INSA-GEI/Voilier/README.md

# Voilier
Évolution du voilier utilisé dans l'apprentissage de la programmation de périphériques MCU

## Organisation du dépôt git
La structure du dépôt suit cette organisation:
- docs: Documentation du projet
- meca: Conception de pièces mécaniques et supports utilisé sur le projet (Autodesk Inventor)
- pcb: Conception des différentes cartes électronique composants le projet (Kicad / Altium)
- code: Code source des différents logiciels utilisés sur le projet (stm32CubeIDE / python)

## Contributeurs
L'équipe enseignante et l’équipe technique du département GEI, spécialité électronique, de l'INSA de Toulouse, France.

## Config XBEE

Voilier
Channel: F
PanID: 111
My : n
Dest : 0x80+n

Telecommande:
Channel: F
PanID: 111
My: 0x80+n
Dest: n
