INSA-GEI/Voilier/docs/SysML/interface-schemaJose_CoorTR_29Mars.pdf

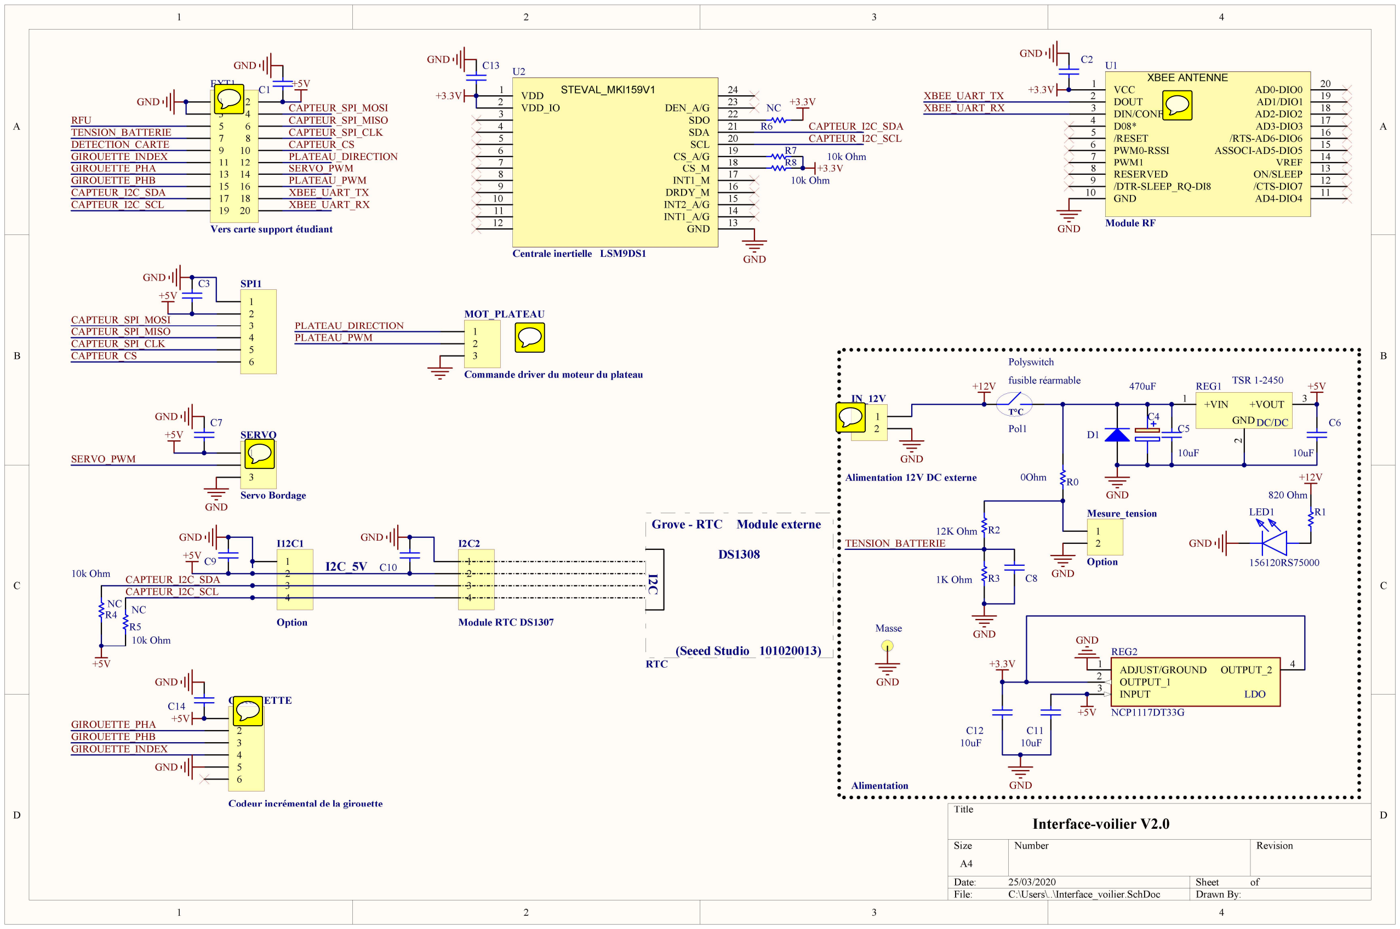
[picture p24: page 1]

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
Title

Size | Number | | Revision
A4
Date: | 25/03/2020 | Sheet | of
File: | C:\Users\..\Interface_voilier.SchDoc | Drawn By:

+5V

1
2
3
4

I12C1
+5V

+5V
1
2
3

SERVO

1
2

IN_12V

D1

## Interface-voilier V2.0

+5V

1
2
3
4
5
6

GIROUETTE

1
2
3

MOT_PLATEAU

+12V

Module RTC DS1307

1
2
3
4

I2C2

1
2
3
4
5
6

SPI1
+5V

Centrale inertielle LSM9DS1

1 2
3 4
5 6
7 8
9 10
11 12
13 14
15 16
17 18
19 20

EXT1
GND

+5V

CAPTEUR_SPI_MOSI
CAPTEUR_SPI_MISO
CAPTEUR_SPI_CLK
CAPTEUR_CS
PLATEAU_DIRECTION
SERVO_PWM
PLATEAU_PWM
XBEE_UART_TX
CAPTEUR_I2C_SCL | XBEE_UART_RX

CAPTEUR_I2C_SDA

GIROUETTE_PHB

GIROUETTE_PHA

GIROUETTE_INDEX

DETECTION_CARTE

TENSION_BATTERIE

RFU

CAPTEUR_SPI_MOSI
CAPTEUR_SPI_MISO
CAPTEUR_SPI_CLK
CAPTEUR_CS

PLATEAU_DIRECTION
PLATEAU_PWM

SERVO_PWM

CAPTEUR_I2C_SCL

CAPTEUR_I2C_SDA

GIROUETTE_PHB

GIROUETTE_PHA

GIROUETTE_INDEX

TENSION_BATTERIE

VCC 1
DOUT 2
DIN/CONFIG 3

/RESET 5

D08* 4

PWM0-RSSI 6
PWM1 7
RESERVED 8

XBEE ANTENNE

/DTR-SLEEP_RQ-DI8 9
GND 10
AD0-DIO0 | 20
AD1/DIO1 | 19
AD2-DIO2 | 18
AD3-DIO3 | 17
/RTS-AD6-DIO6 | 16
ASSOCI-AD5-DIO5 | 15
VREF | 14
ON/SLEEP | 13
/CTS-DIO7 | 12
AD4-DIO4 | 11

U1

+3.3V

GND

GND

XBEE_UART_TX
XBEE_UART_RX

Alimentation 12V DC externe

Commande driver du moteur du plateau

Codeur incrémental de la girouette

Servo Bordage

+12V

ADJUST/GROUND 1
OUTPUT_1 2
INPUT 3

OUTPUT_2 4

REG2

NCP1117DT33G

GND

GND

+3.3V

Masse

GND

C1

C2

C3

C7

C9

10uF

C5

10uF

C6

C8

GND

GND

10uF

C12
10uF

C11

820 Ohm
R1
12K Ohm R2

1K Ohm R3 10k Ohm

R4

10k Ohm

R5

+5V C14

GND

C10

GND

GND2

+VOUT 3 +VIN 1

REG1 TSR 1-2450

LDO

DC/DC

LED1

156120RS75000

VDD 1
VDD_IO 2
3

5

4

6
7
8

STEVAL_MKI159V1

9
10
SDA | 21
SCL | 20
CS_A/G | 19
CS_M | 18
INT1_M | 17
INT2_A/G | 15
INT1_A/G | 14
GND 12 | 13

11

SDO | 22 DEN_A/G | 23

24

DRDY_M 16

U2

GND

+3.3V

C13 GND

CAPTEUR_I2C_SCL

CAPTEUR_I2C_SDA

10k Ohm R7

10k Ohm

R8

R6

Option

+3.3V

+3.3V NC

GND

GND

GND

GND

GND

GND

GND

Module RF

+5V

### I2C_5V

### Grove - RTC

DS1308

### (Seeed Studio 101020013) I2C

### Module externe

470uF

C4 T°C
Pol1

Polyswitch
fusible réarmable

NC NC

0Ohm R0

1
2

Mesure_tension

GND

GND

Vers carte support étudiant

Alimentation

RTC

Option
