INSA-GEI/Voilier/code/README.md

# Documentation
Répertoire prévu pour recevoir le code logiciel des differents composants du projet.
