INSA-GEI/Voilier/docs/README.md

# Documentation
Répertoire utilisé pour stocker la documentation du projet
