INSA-GEI/Voilier/meca/README.md

# Mecanique
Répertoire dedié aux conceptions de pieces mecaniques pour le projet
