INSA-GEI/Voilier/pcb/README.md

# Documentation
Répertoire utilisé pour la conception des cartes électroniques du projet
