INSA-GEI/Voilier/pcb/carte_alim/PDF/Carte_alim_TOP.pdf

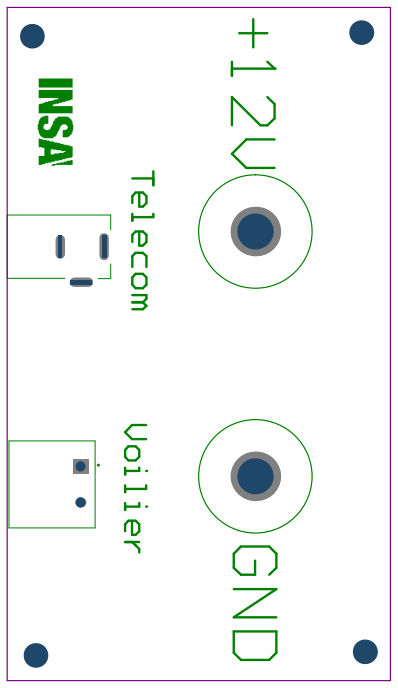
[picture p25: figure]
