INSA-GEI/Voilier/code/Console-Pilotage/TouchGFX/assets/images/counter_box-120x122.png

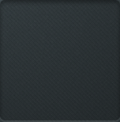
code/Console-Pilotage/TouchGFX/assets/images/counter_box-120x122.png
