INSA-GEI/Voilier/code/Console-Pilotage/TouchGFX/assets/images/sailboat-large.png

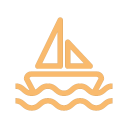
code/Console-Pilotage/TouchGFX/assets/images/sailboat-large.png
