INSA-GEI/Voilier/docs/chiffrage_initial.ods

Chiffrage prévisionnel pour l’évolution du voilier 2020 Version 2 (11/02/2020) |  |  |  |  |  | Les noms des cartes ne correspondent pas. Faut qu'on se cale et qu'on s'y tienne. Je veux bien changer mais stabilisons au plus Vite les nomenclatures, source d'embrouille Sinon
Cartes étudiants
Nombre d’unités : | 100
BOM par carte
Description | Reference | Prix unitaire | Quantité | Total par unité | Commentaire
PCB (75*80) |  | 5,2063 | 1 | 5,2063 | Verni epargne, simple face, serigraphie sur face avant | Taille ? Simple face ?
Nucleo F103 | https://www.mouser.fr/ProductDetail/STMicroelectronics/NUCLEO-F103RB | 9,66 | 0 | 0
Connecteur peripherique | https://fr.rs-online.com/web/p/embases-circuits-imprimes/6705060/ | 0,421 | 1 | 0,421
Connecteur Nucleo | https://fr.rs-online.com/web/p/fiches-femelles-pour-ci/1548329/ | 1,266 | 2 | 2,532 |  | virer et remplacer par deux vis 3mm ? Moins cher ? Et éviterait des soudures inutiles ?
Cables Dupont | https://fr.rs-online.com/web/p/products/7916450/ | 3,38 | 1 | 3,38
Total |  |  |  | 1153,93
Cartes Enseignants
Nombre d’unités : | 3
BOM par carte
Description | Reference | Prix unitaire | Quantité | Total par unité | Commentaire
PCB (140*80) |  | 43,6666666666667 | 1 | 43,6666666666667 | Verni epargne, double face, serigraphie sur face avant
Nucleo F103 | https://www.mouser.fr/ProductDetail/STMicroelectronics/NUCLEO-F103RB | 9,66 | 0 | 0
Ecran lcd | https://fr.farnell.com/mikroelektronika/mikroe-495/afficheur-protocarte-tft-320x240/dp/2281683 | 33,456 | 1 | 33,456
Connecteur Nucleo | https://fr.rs-online.com/web/p/fiches-femelles-pour-ci/1548329/ | 1,266 | 2 | 2,532
Total |  |  |  | 238,964
Cartes voilier
Nombre d’unités : | 6
BOM par carte
Description | Reference | Prix unitaire | Quantité | Total par unité |  | Connecteur board de carte 15 pos ??
PCB (100*80) |  | 26,3333333333333 | 1 | 26,3333333333333 | Verni epargne, double face, serigraphie sur face avant
Xbee S2C | https://fr.rs-online.com/web/p/kits-de-developpement-pour-radio-frequence/1359730/ | 21,5 | 1 | 21,5
Connecteur Xbee | https://fr.rs-online.com/web/p/fiches-femelles-pour-ci/6058796/ | 1,463 | 2 | 2,926
Connecteur nappe | https://fr.rs-online.com/web/p/embases-circuits-imprimes/8323500/ | 0,389 | 1 | 0,389
Regulateur 5V | https://www.mouser.fr/ProductDetail/Texas-Instruments/LM1085IT-50-NOPB | 1,73 | 1 | 1,73
Regulateur 3V | https://www.mouser.fr/ProductDetail/Texas-Instruments/LM1085IT-33-NOPB | 1,73 | 1 | 1,73
Level Shifter 3,3v – 5V | https://www.mouser.fr/ProductDetail/Texas-Instruments/SN74LVC2T45DCTR | 0,531 | 2 | 1,062
Buffers | https://www.mouser.fr/ProductDetail/Texas-Instruments/SN74LVC2G17DBVR | 0,351 | 6 | 2,106
Total |  |  |  | 346,658
Pupitre de commande
Nombre d’unités : | 7
BOM par carte
Description | Reference | Prix unitaire | Quantité | Total par unité
PCB (60x60) |  | 18 | 1 | 18 | Verni epargne, double face, serigraphie sur face avant
Xbee S2C | https://fr.rs-online.com/web/p/kits-de-developpement-pour-radio-frequence/1359730/ | 21,5 | 1 | 21,5
Connecteur Xbee | https://fr.rs-online.com/web/p/fiches-femelles-pour-ci/6058796/ | 1,463 | 2 | 2,926
Connecteurs « arduino » |  | 2,529 | 1 | 2,529
Carte STM32F746G-DISCO | https://www.mouser.fr/ProductDetail/STMicroelectronics/STM32F746G-DISCO | 52,65 | 1 | 52,65
Boitier | https://www.mouser.fr/ProductDetail/Hammond-Manufacturing/1597DGY | 14,36 | 1 | 14,36 |  | J'ai pas d'avis sur le design, mais faudrait Qu'on s'y intéresse tous.
Total |  |  |  | 783,755
Boitier de simulation
Nombre d’unités : | 12
BOM par carte
Description | Reference | Prix unitaire | Quantité | Total par unité
PCBs (60x60) + (90x50) |  | 38 | 1 | 38 | Verni epargne, double face, serigraphie sur face avant
Connecteur board de carte 15 pos | https://www.mouser.fr/ProductDetail/TE-Connectivity-AMP/5530841-2 | 2,8 | 1 | 2,8
Connecteur nappe | https://fr.rs-online.com/web/p/embases-circuits-imprimes/8323500/ | 0,389 | 2 | 0,778 |  | As tu compté le nbre de pins nécessaire ?
Connecteurs « arduino » |  | 2,529 | 1 | 2,529
Carte STM32F746G-DISCO | https://www.mouser.fr/ProductDetail/STMicroelectronics/STM32F746G-DISCO | 52,65 | 1 | 52,65
Level Shifter 3,3v – 5V | https://www.mouser.fr/ProductDetail/Texas-Instruments/SN74LVC2T45DCTR | 0,531 | 2 | 1,062
Buffers | https://www.mouser.fr/ProductDetail/Texas-Instruments/SN74LVC2G17DBVR | 0,351 | 6 | 2,106
Boitier | https://www.mouser.fr/ProductDetail/Hammond-Manufacturing/515-0920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 | 27,42 | 1 | 27,42
Total |  |  |  | 1528,14
Mecanique
Nombre d’unités : | 7 |  |  |  |  | Voir avec la team. J'ai pas trop d'avis.
BOM par voilier
Description | Reference | Prix unitaire | Quantité | Total par unité
Chaine | https://fr.rs-online.com/web/p/chaines-a-rouleaux/1463746/ | 5,9292 | 1 | 5,9292
Pignon moteur | https://fr.rs-online.com/web/p/pignons/0184886/ | 3,596 | 1 | 3,596
Pignon Axe | https://fr.rs-online.com/web/p/pignons/0184088/ | 10,595 | 1 | 10,595
Pignon de tension de chaine | https://fr.rs-online.com/web/p/pignons/0184870/ | 3,13 | 1 | 3,13
Moteur | https://fr.rs-online.com/web/p/motoreducteurs-a-courant-continu/2985458/ | 35,068 | 1 | 35,068
Total |  |  |  | 408,2274
Total du projet |  |  |  | 4459,6744
