INSA-GEI/Voilier/meca/Content center files/c-5-5530843-4-f-3d.stp

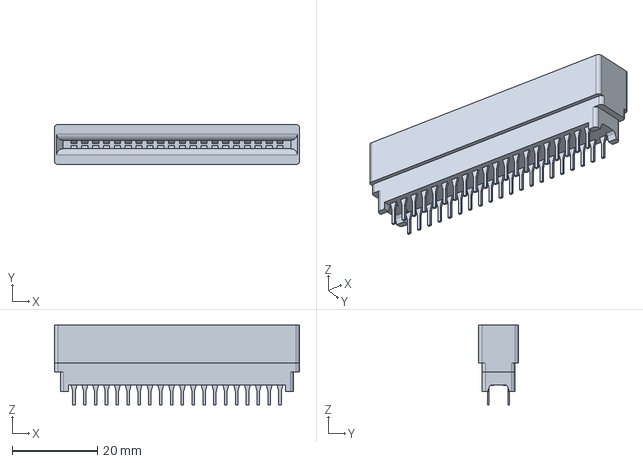
[picture p28: CAD file, 2021-06-11]
meca/Content center files/c-5-5530843-4-f-3d.stp
57.4 x 9.35 x 18.7 mm
