INSA-GEI/Voilier/meca/Content center files/ENG_CVM_CVM_5-5530843-4_F.2d_dxf/c-5-5530843-4-f-2d.dxf

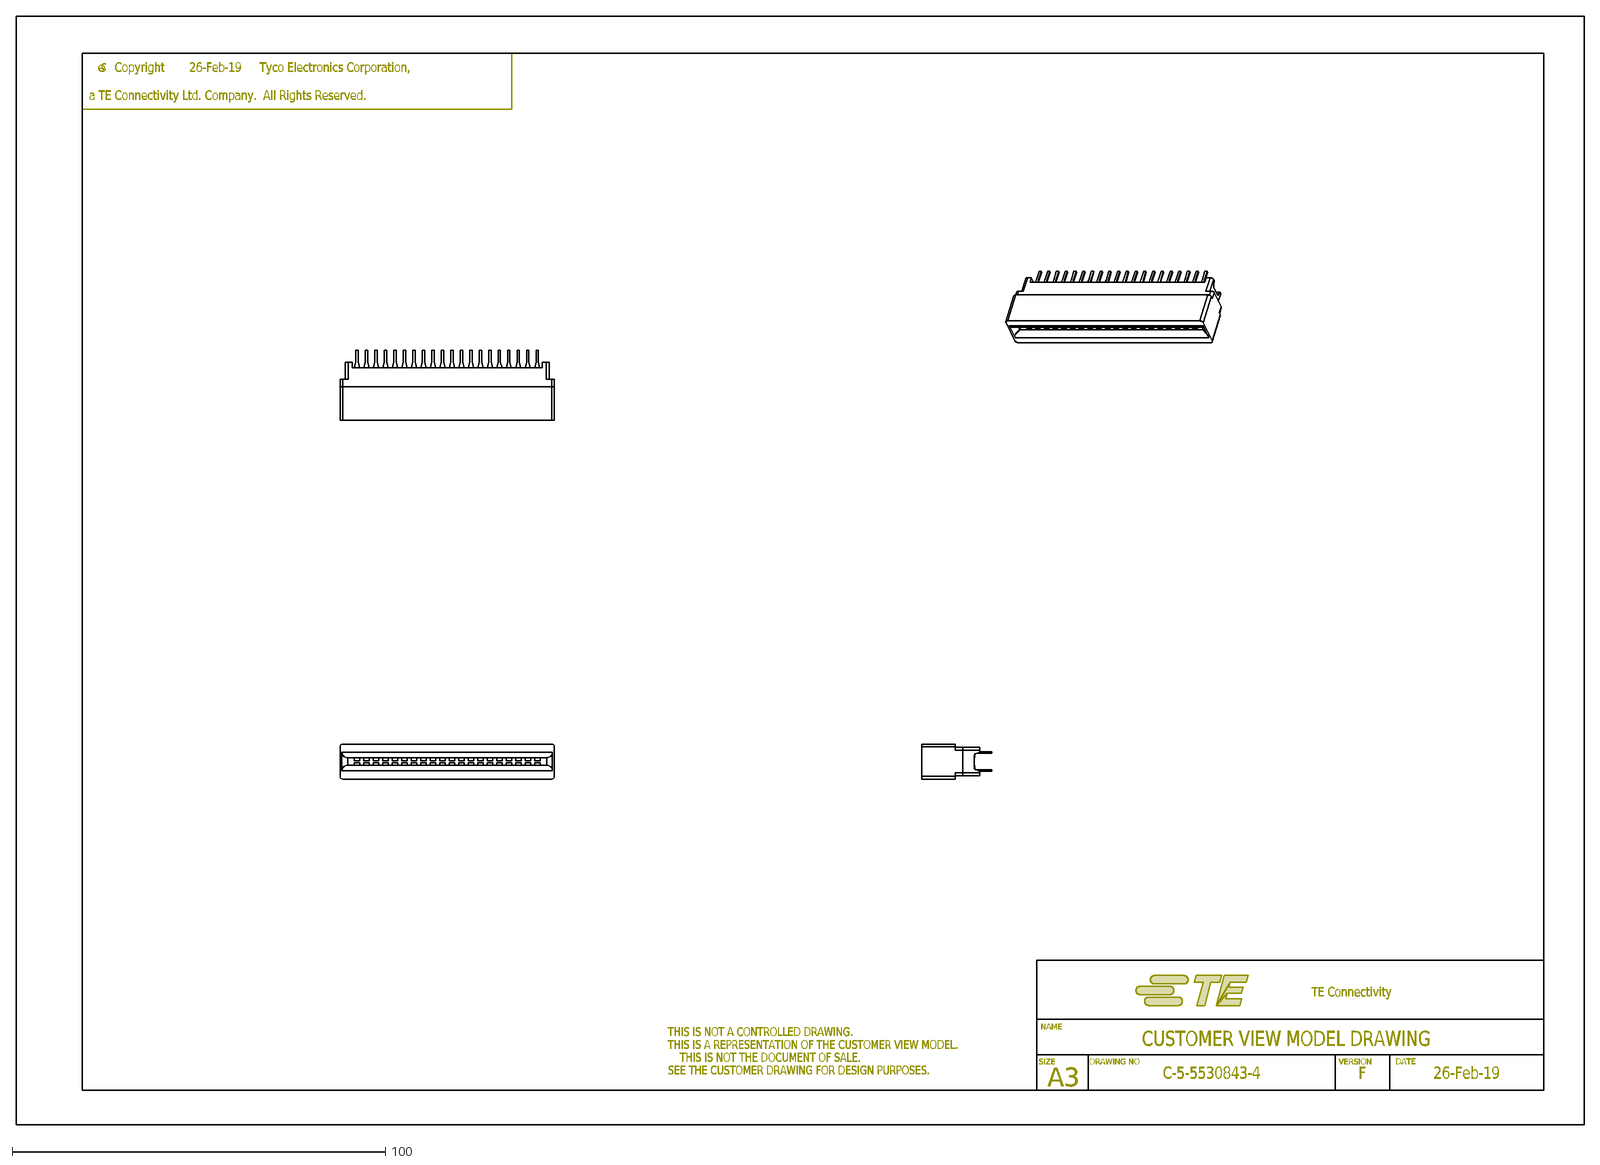
[picture p29: CAD file, 2021-06-11]
meca/Content center files/ENG_CVM_CVM_5-5530843-4_F.2d_dxf/c-5-5530843-4-f-2d.dxf
SIZE
DRAWING NO
VERSION
NAME
A3
CUSTOMER VIEW MODEL DRAWING
TE Connectivity
DATE
THIS IS NOT A CONTROLLED DRAWING.
THIS IS A REPRESENTATION OF THE CUSTOMER VIEW MODEL.
THIS IS NOT THE DOCUMENT OF SALE.
SEE THE CUSTOMER DRAWING FOR DESIGN PURPOSES.
c
C-5-5530843-4
F
26-Feb-19
Copyright
Tyco Electronics Corporation,
a TE Connectivity Ltd. Company. All Rights Reserved.
