INSA-GEI/Voilier/meca/Equerres porte carte/Fixation gauche.stp

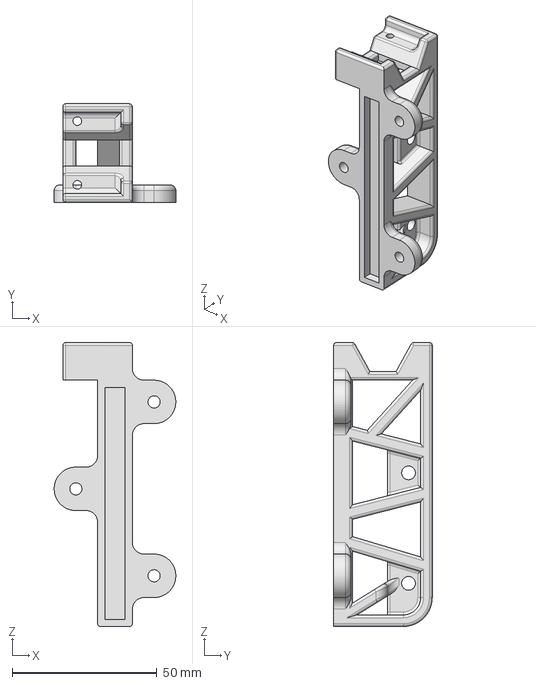
[picture p30: CAD file, 2021-06-11]
meca/Equerres porte carte/Fixation gauche.stp
42.0 x 34.0 x 98.0 mm
