INSA-GEI/Voilier/meca/Content center files/c-1-1734592-0-c-3d.stp

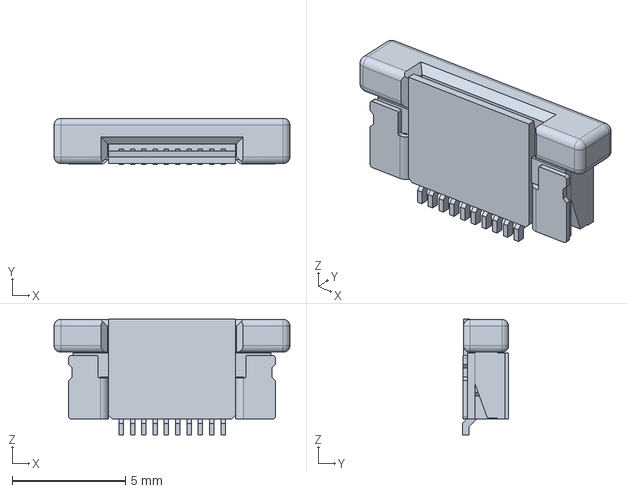
[picture p31: CAD file, 2021-06-11]
meca/Content center files/c-1-1734592-0-c-3d.stp
10.4 x 2.05 x 5.11 mm
