INSA-GEI/Voilier/meca/Content center files/c-1-1734592-0-c-2d.dxf

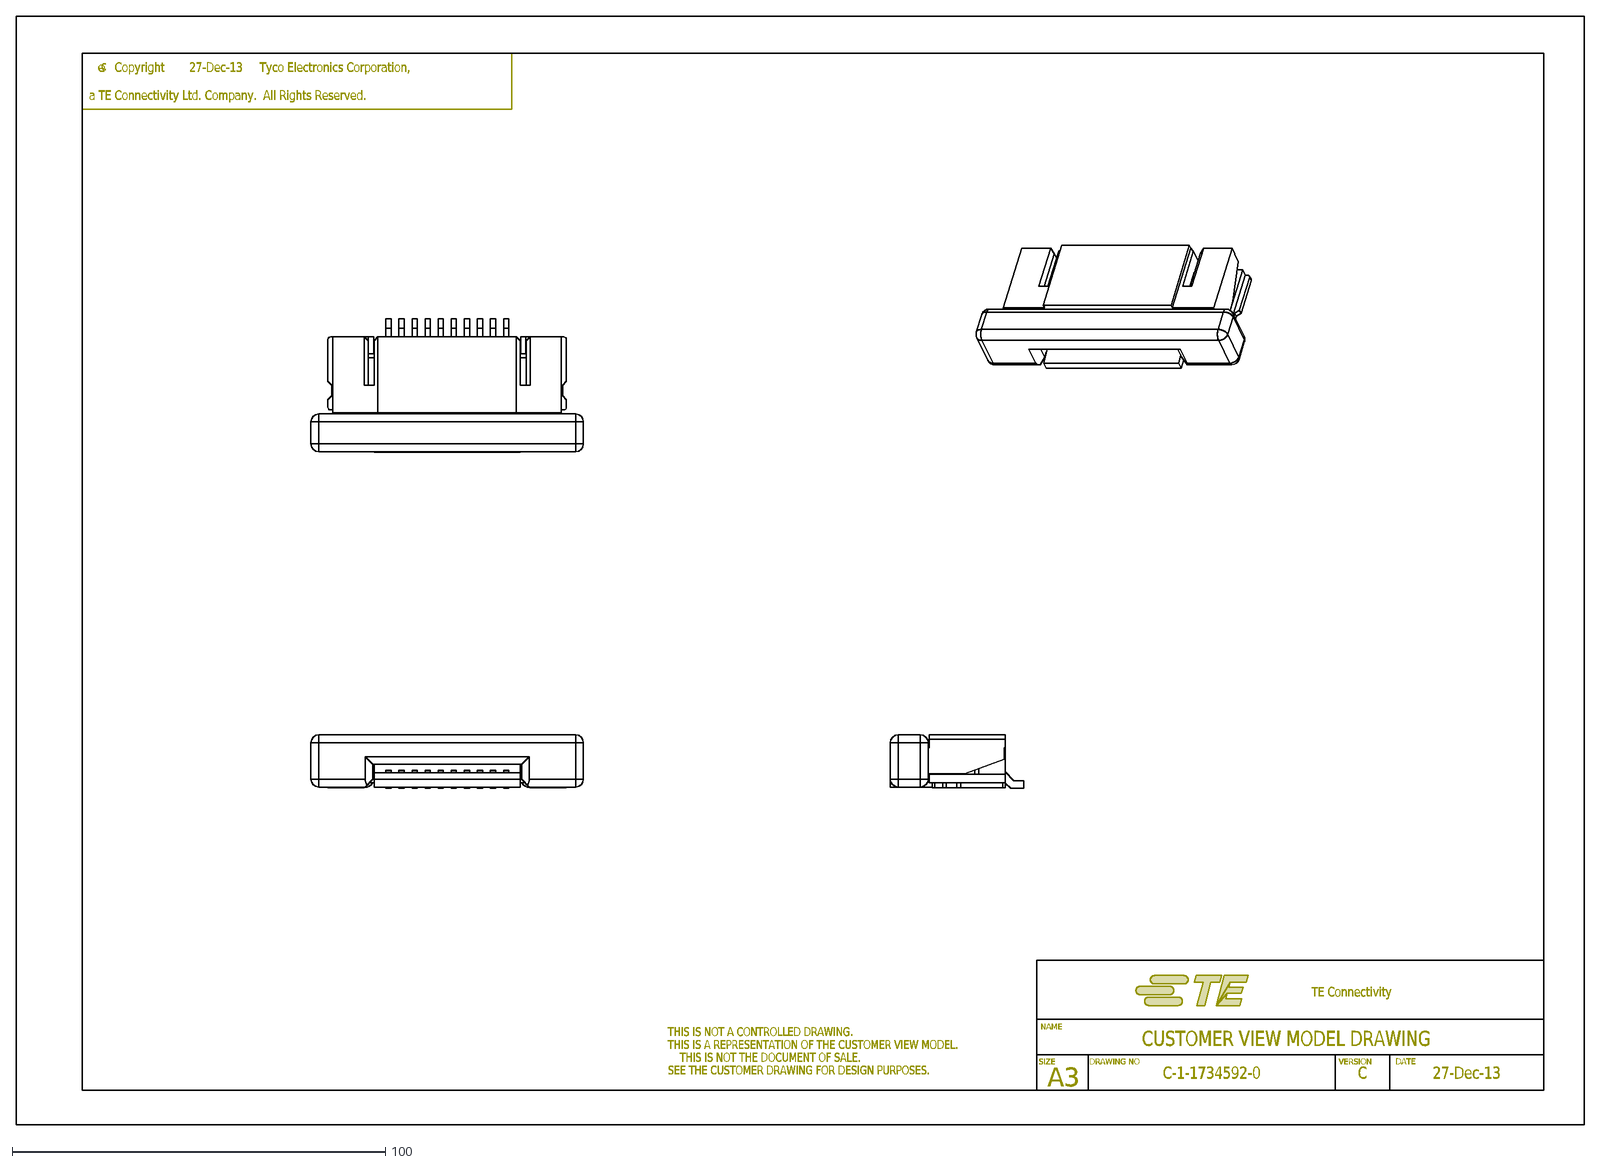
[picture p32: CAD file, 2021-06-11]
meca/Content center files/c-1-1734592-0-c-2d.dxf
SIZE
DRAWING NO
VERSION
NAME
A3
CUSTOMER VIEW MODEL DRAWING
TE Connectivity
DATE
THIS IS NOT A CONTROLLED DRAWING.
THIS IS A REPRESENTATION OF THE CUSTOMER VIEW MODEL.
THIS IS NOT THE DOCUMENT OF SALE.
SEE THE CUSTOMER DRAWING FOR DESIGN PURPOSES.
c
C-1-1734592-0
C
27-Dec-13
Copyright
Tyco Electronics Corporation,
a TE Connectivity Ltd. Company. All Rights Reserved.
