INSA-GEI/Voilier/meca/Content center files/71600-020_asm.stp

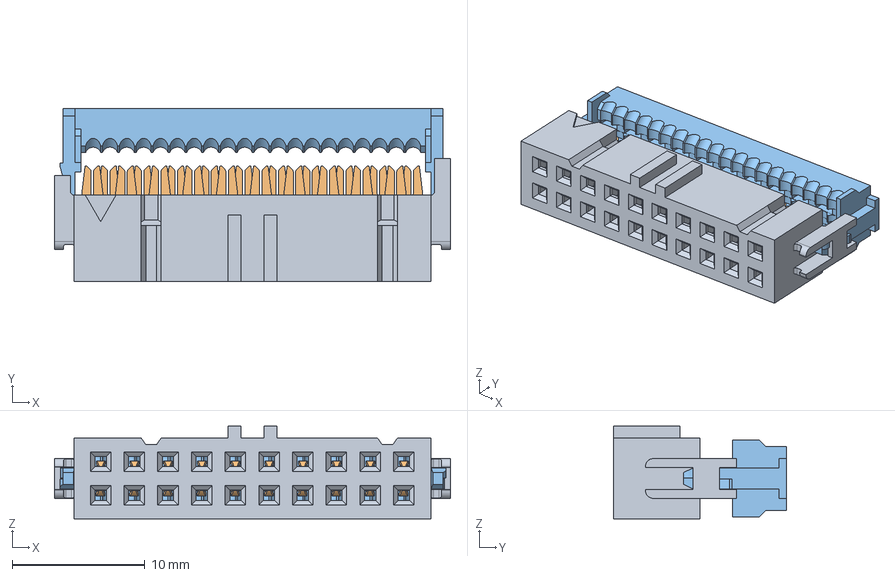
[picture p33: CAD file, 2021-06-11]
meca/Content center files/71600-020_asm.stp
29.9 x 13.0 x 7.00 mm
71902_Y20
67015_Y20
