INSA-GEI/Voilier/(list of files, cad)

Other CAD files:
meca/Equerres porte carte/Fixation droite.stp
meca/Content center files/ENG_CVM_CVM_5-5530843-4_F.3d_igs/c-5-5530843-4-f-3d.igs
meca/Content center files/c-1-1734592-0-c-3d.igs
meca/Content center files/carte_etudiant/COMPOUND_1.ipt
meca/Content center files/carte_etudiant/NUCLEO-60-F401.iam
meca/Content center files/carte_etudiant/PinHeader_1x16_P2.54mm_Vertical.iam
meca/Content center files/carte_etudiant/PinSocket_1x16_P2.54mm_Vertical.iam
meca/Content center files/carte_etudiant/SOLID.ipt
meca/Content center files/carte_etudiant/SOLID_1.ipt
meca/Content center files/carte_etudiant/carte_etudiant.iam
meca/Content center files/pcb_accueil/COMPOUND.ipt
meca/Content center files/pcb_accueil/C_1206_3216Metric.iam
meca/Content center files/pcb_accueil/IDC-Header_2x10_P2.54mm_Vertical.iam
meca/Content center files/pcb_accueil/LED_1206_3216Metric.iam
meca/Content center files/pcb_accueil/R_1206_3216Metric.iam
meca/Content center files/pcb_accueil/SOLID.ipt
meca/Content center files/pcb_accueil/SOLID_1.ipt
meca/Content center files/pcb_accueil/SOLID_2.ipt
meca/Content center files/pcb_accueil/SOLID_3.ipt
meca/Content center files/pcb_accueil/SOLID_4.ipt
meca/Content center files/pcb_accueil/c-5-5530843-4-f-3d.iam
meca/Content center files/pcb_accueil/pcb_accueil.iam
meca/Equerres porte a faux/Equerre_porte_a_faux_droit.ipt
meca/Equerres porte a faux/Equerre_porte_a_faux_gauche.ipt
meca/Equerres porte a faux/Pont_arriere.ipt
meca/Equerres porte carte/Ensemble - Glissiere Gauche.iam
meca/Equerres porte carte/Ensemble - Glissiere droite.iam
meca/Equerres porte carte/Fixation droite.ipt
meca/Equerres porte carte/Fixation droite.stl
meca/Equerres porte carte/Fixation gauche.ipt
meca/Equerres porte carte/Fixation gauche.stl
meca/Equerres porte carte/Plateau.ipt
meca/Equerres porte carte/RDC-250.ipt
meca/Equerres porte carte/Tube alu.ipt
meca/Equerres porte carte/pcb_connecteur.ipt
pcb/pcb_accueil/COMPOUND.ipt
pcb/pcb_accueil/PinHeader_2x10_P2.54mm_Vertical.iam
pcb/pcb_accueil/PinSocket_2x20_P2.54mm_Vertical.iam
pcb/pcb_accueil/SOLID.ipt
pcb/pcb_accueil/SOLID_1.ipt
pcb/pcb_accueil/SOLID_2.ipt
pcb/pcb_accueil/c-5-5530843-4-f-3d.iam
pcb/pcb_accueil/pcb_accueil.iam
