INSA-GEI/Voilier/docs/SysML/UseCase Tests avec Banc de tests.pdf

Cameo Systems Modeler, 1-1 D:\Thierry\2013_2016\GitHubINSA\Voilier\docs\SysML\Bateau_2020.mdzip Tester une solution logicielle sur un simulateur du voili

Version Académique pour Professeur Seulement, Le Développement Commercial est strictement interdit

# Version Académique pour P Le Développement Commercia

# Version Académique pour Professeur Seulement

# Le Développement Commercial est strictement interdit

# Version Académique pour Professeur Seulement

# Le Développement Commercial est strictement interdit

# Version Académique pour Professeur Seulement

# Le Développement Commercial est strictement interdit

# our Professeur Seulement

# ercial est strictement interdit

# Version Académique pour Professeur Seulement

# Le Développement Commercial est strictement interdit

# Version Académique pour Professeur Seulement

# Le Développement Commercial est strictement interdit

# dit

uc [Cas d'Utilisation] Tester une solution logicielle sur un simulateur du voilier Tester une solution logicielle sur un simul [ | ateur du voilier ]

### Banc de tests

tester le bordage des voiles

Régler sur l'écran tactile l'angle du vent par rapport à l'axe logitudinal orienté de l'avant vers l'arrière du voilier (dès qu'un rotation est faite les impulsions A/B/I sont
générées en tps réel)

points d'extension

Si "gestion Batt" Activé

Si "feedback" activé

Test complet

L'étudiant communique avec l'accéléro
(idem, embarquer le module accéléro et le déporter hors banc pour pouvoir l'animer) I2C

Le user peut agir sur la tension 12V

la console de commande
virtuelle affiche les messages reçus

Voiles + rotation :
Le vent est fixé, par exemple de haut en bas de l'écran. Le user agit sur la console virtuelle : le bateau tourne et les voiles s'adaptent.

console vers voilier. Le user peut choisir parmi 4 textes prédéfinis. Il les lance et doit récupérer les messages
dans son STM32

Visualiser la voile principale qui s'adapte à l'angle de la girouette (si l'étudiant a bien travaillé !)

Visualiser sur l'écran le
plateau qui de met en
rotation (si l'étudiant a
bien travaillé !)

commander le plateau en
agissant sur une molette
virtuelle de l'écran tactile (des messages sont émis
via UART)

tester la rotation du plateau

Létudiant peut vérifier
L'étudiant peut voir les | l'incrémementation du CNT
signaux A, B, I sur l'oscillo L'étudiant peut faire tourner la girouette
virtuellement sur le
banc de test

Tester codeur incr.

### Use Case intégration complète

L'étudiant peut
communique avec le
RTC
(Le plus simple est
d'embarquer le RTC !)
I2C ou SPI

Voilier vers console
de pilotage. Le banc
se comporte en
simple terminal (le
débit est imposé)

Tester l'UART seule

Test I2C / SPI

La tension
analogique se
modifie et
l'utilisateur peut
voir le résultat
de la conv ADC

L'étudiant peut
ajuster avec une
molette virtuelle
la tension 12V du
bateau.

Tester l'ADC

### Use Case premiers

tests d'intégration | Use Case Test
| unitaires de
| développement

PC+KEIL+Sonde

PC+KEIL+Sonde

PC+KEIL+Sonde
PC+KEIL+Sonde

Etudiant

«include»

«extend»
(Si "feedback" activé)
«include» | «include» «extend»

(Si "gestion Batt" Activé)

«include»

«include»

«include»

«include»
«include»
«include» | «include»

«include»

«include»
«include»

«include»
