INSA-GEI/Voilier/docs/SysML/Ibd_Banc_De_Test.pdf

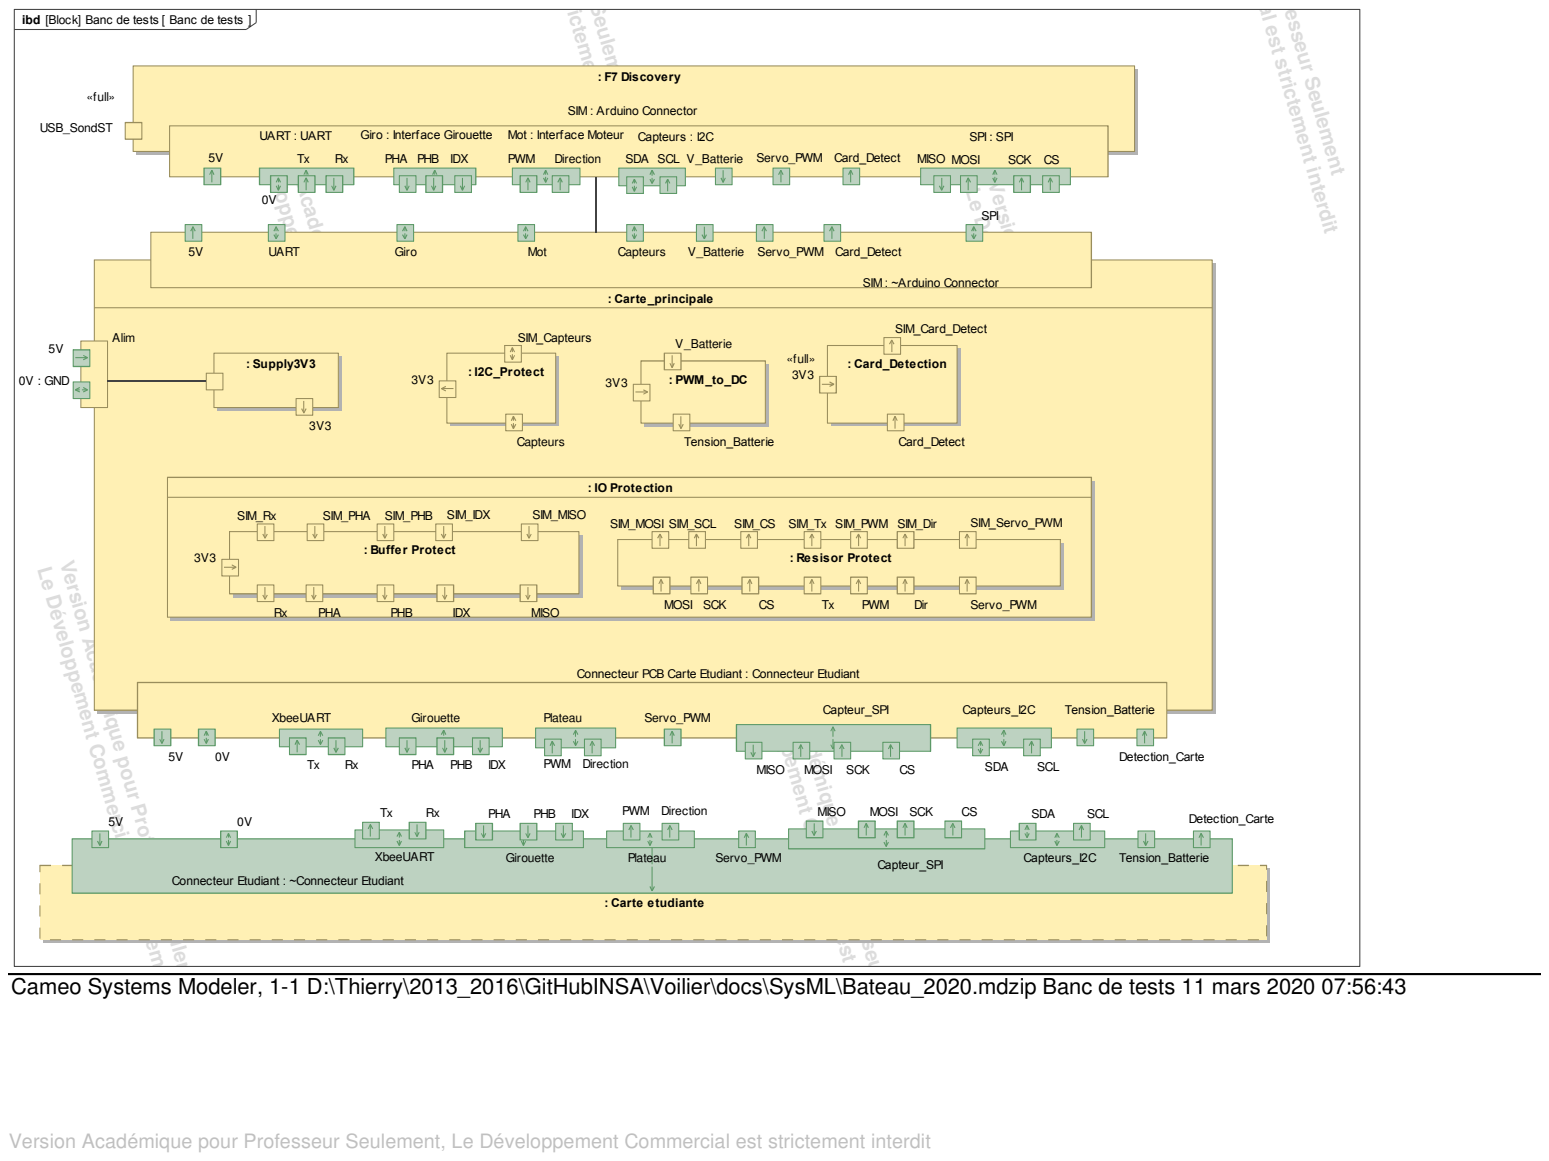
[picture p34: page 1]
fesseur Seulement; Version Académique; Seulement; rictement interdit; pour Professeu; ibd [Block] Banc de tests Banc de tests [; : Carte etudiante; MISO; MOSI SCK; Capteur_SPI; PHA; PHB; IDX; Girouette; SDA; SCL; Capteurs_I2C; XbeeUART; PWM Direction; Plateau; Servo_PWM; Tension_Batterie; Detection_Carte; : Resisor Protect; SIM_Tx SIM_PWM SIM_Dir; SIM_Servo_PWM; PWM; Dir; SIM_MOSI SIM_SCL; SIM_CS; : Buffer Protect 3V3; SIM_Rx; SIM_PHA; SIM_PHB; SIM_IDX; SIM_MISO; : IO Protection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

al est strictement interdit

SIM : Arduino Connector

Développement Commercial est strictement interdit

Giro : Interface Girouette

Mot : Interface Moteur

PHA PHB IDX

SIM : ~Arduino Connector

pour Professeur Seulement

Développement Commercial est strictem

Connecteur PCB Carte Etudiant : Connecteur Etudiant

Développement Commercial est

pour Professeur Seule

Connecteur Etudiant : ~Connecteur Etudiant

Cameo Systems Modeler, 1-1 D:\Thierry\2013_2016\GitHubINSA\Voilier\docs\SysML\Bateau_2020.mdzip Banc de tests 11 mars 2020 07:56:43

Version Académique pour Professeur Seulement, Le Développement Commercial est strictement interdit
