INSA-GEI/Voilier/pcb/carte_alim/PDF/Schematic carte alim.pdf

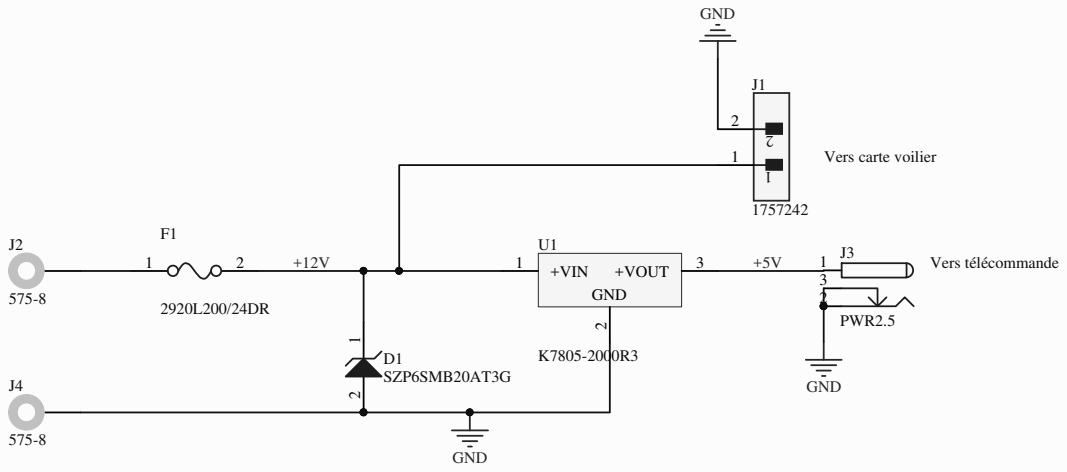
[picture p35: page 1]
Title; Size; Number; Revision; Date:; Sheet; File:; U:\Windows\..\Voilier_carte_alim.SchDocDrawn By:; Carte Alim; GND; +VOUT; 3 +VIN 1; PWR2.5; D1 SZP6SMB20AT3G; Vers télécommande

Vers carte voilier
