INSA-GEI/Voilier/pcb/Liste_composants_Mouser.pdf

# Politique de confidentialité et de cookies

Mouser Electronics utilise des cookies et d'autres technologies similaires pour fournir la meilleure expérience possible sur son site. Nos cookies sont nécessaires au fonctionnement du site, à la surveillance des performances du site et à la délivrance d'un contenu pertinent. Vous pouvez visiter notre centre de confidentialité pour en
savoir plus sur vos paramètres en ligne.

## Accepter et fermer

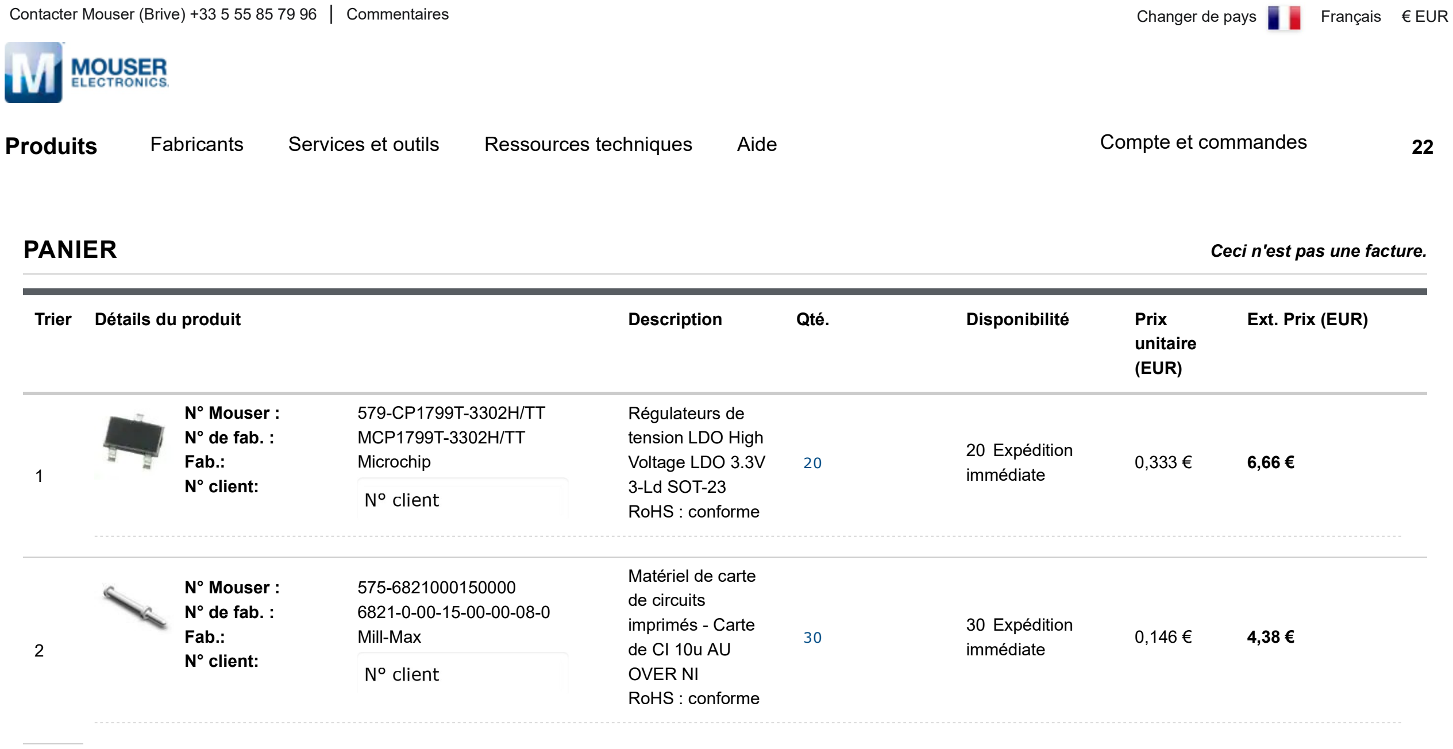
[picture p36: figure]
Trier Détails du produit; Description; Qté.; Disponibilité; Prix; unitaire (EUR); Ext. Prix (EUR); PANIER; Ceci n'est pas une facture.; N° Mouser :; N° de fab. :; MCP1799T-3302H/TT; Fab.:; Microchip; N° client:; Régulateurs de tension LDO High Voltage LDO 3.3V 3-Ld SOT-23 RoHS : conforme; 20 Expédition; immédiate; Mill-Max; Matériel de carte de circuits imprimés - Carte de CI 10u AU OVER NI RoHS : conforme; 30 Expédition; Produits; Fabricants; Services et outils; Ressources techniques; Aide; Compte et commandes

Contacter Mouser (Brive) +33 5 55 85 79 96 | Commentaires | Changer de pays | Français | € EUR
Mon panier | Mouser France | https://www.mouser.fr/Cart/
1 sur 6 | 20/04/2020 à 11:23

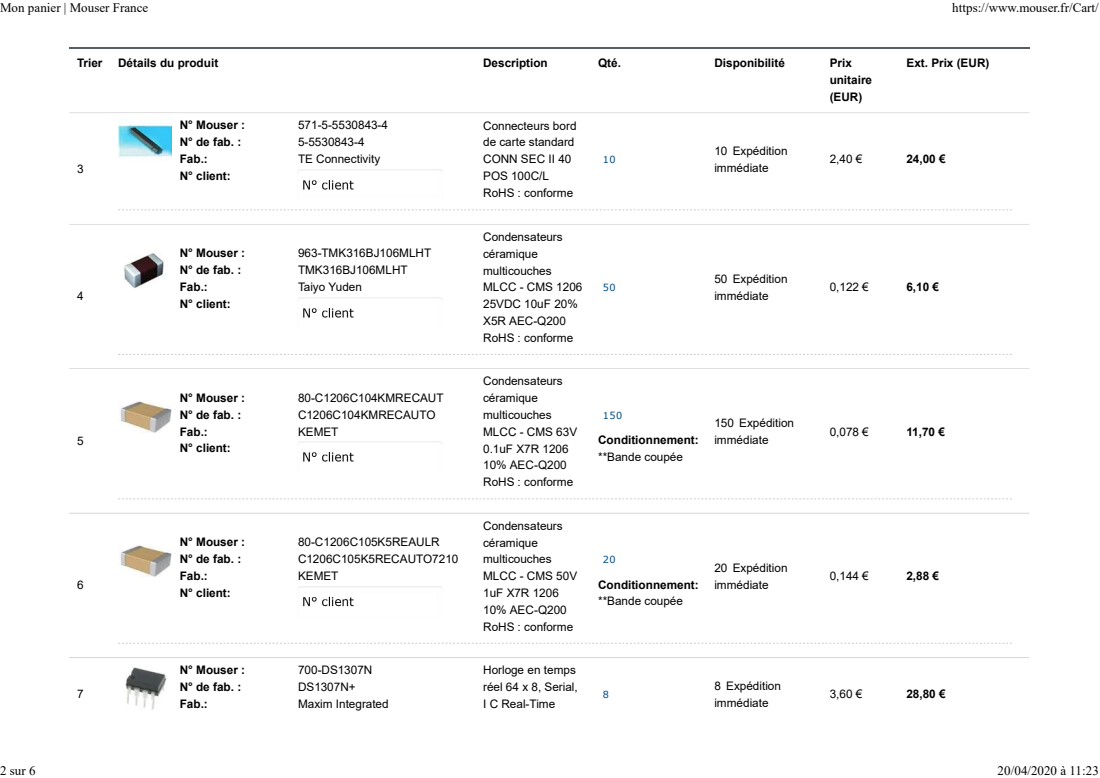
[picture p37: page 2]
Trier Détails du produit; Description; Qté.; Disponibilité; Prix; unitaire (EUR); N° Mouser :; N° de fab. :; Fab.:; TE Connectivity; N° client:; 10 Expédition; immédiate; 963-TMK316BJ106MLHT; TMK316BJ106MLHT; Taiyo Yuden; Condensateurs céramique multicouches MLCC - CMS 1206 25VDC 10uF 20% X5R AEC-Q200 RoHS : conforme; 50 Expédition; 80-C1206C104KMRECAUT; C1206C104KMRECAUTO; KEMET; Condensateurs céramique multicouches MLCC - CMS 63V 0.1uF X7R 1206 10% AEC-Q200 RoHS : conforme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

Ext. Prix (EUR)

Connecteurs bord
de carte standard
CONN SEC II 40
POS 100C/L
RoHS : conforme

Horloge en temps
réel 64 x 8, Serial,
I C Real-Time

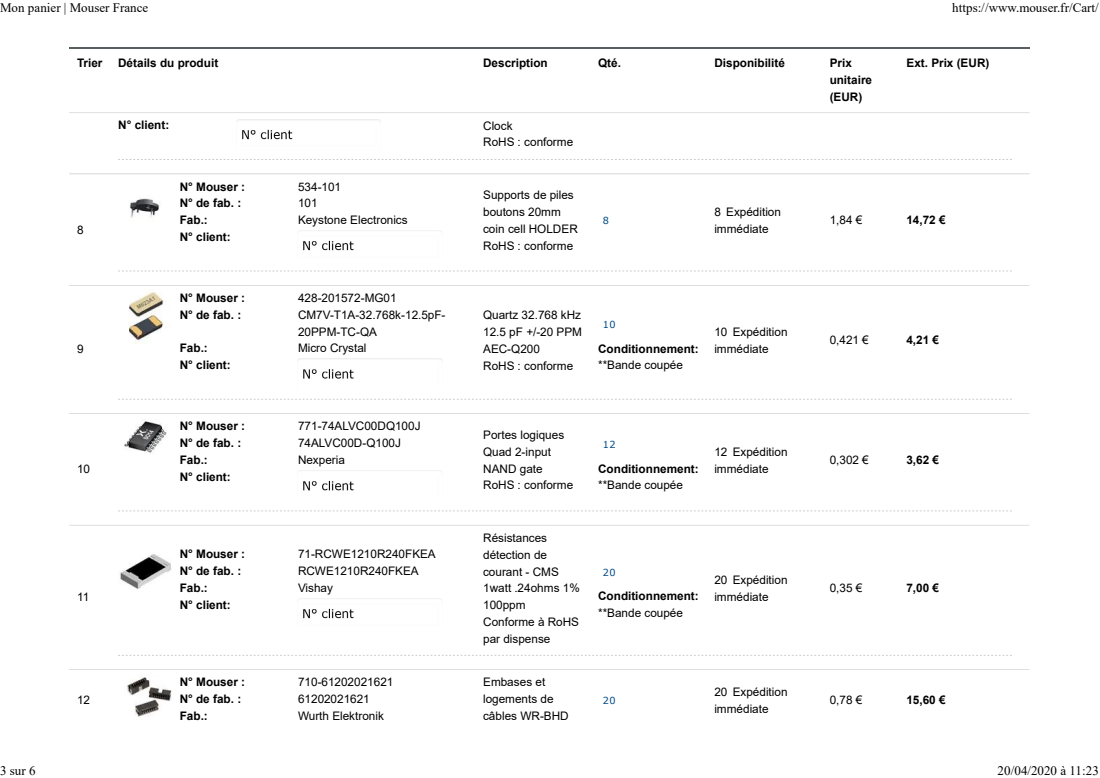
[picture p38: page 3]
unitaire (EUR); N° client:; Clock; RoHS : conforme; N° Mouser :; N° de fab. :; Fab.:; Keystone Electronics; 8 Expédition; immédiate; 20PPM-TC-QA; Micro Crystal; Quartz 32.768 kHz 12.5 pF +/-20 PPM AEC-Q200 RoHS : conforme; Conditionnement: **Bande coupée; 10 Expédition; 771-74ALVC00DQ100J; 74ALVC00D-Q100J; Nexperia; Portes logiques Quad 2-input NAND gate RoHS : conforme; 12 Expédition; 71-RCWE1210R240FKEA; RCWE1210R240FKEA; Vishay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

Supports de piles
boutons 20mm
coin cell HOLDER
RoHS : conforme

Embases et
logements de
câbles WR-BHD

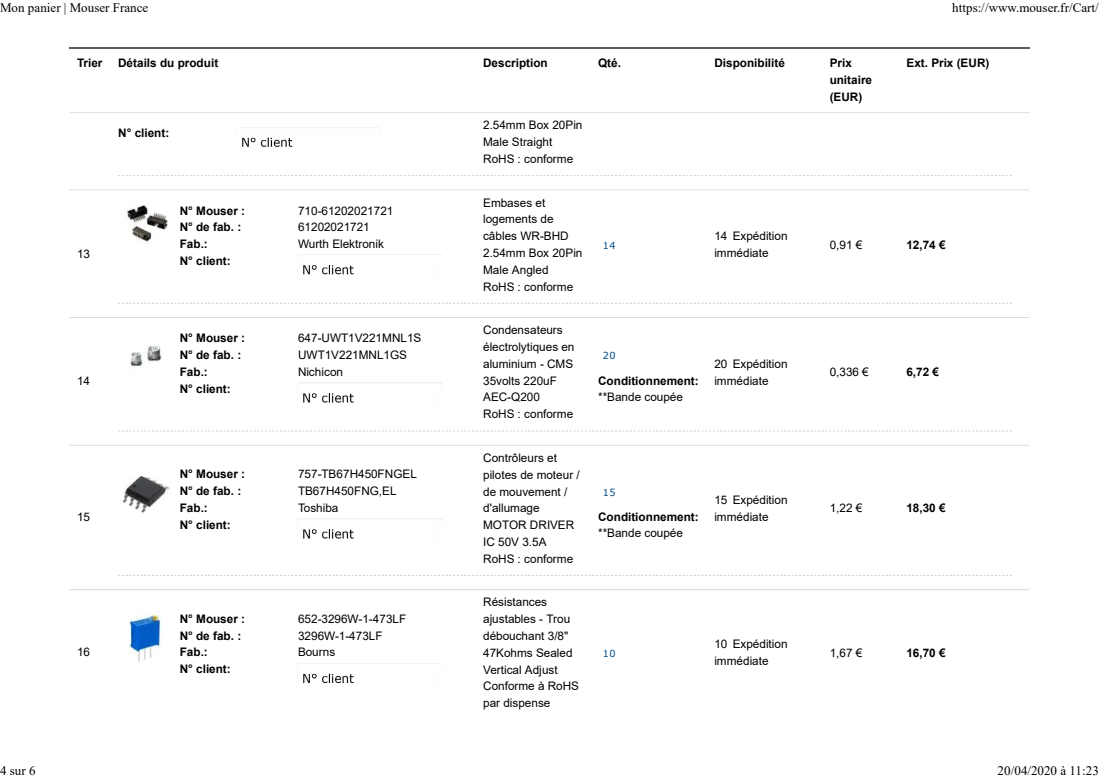
[picture p39: page 4]
unitaire (EUR); N° client:; 2.54mm Box 20Pin; Male Straight RoHS : conforme; N° Mouser :; N° de fab. :; Fab.:; Wurth Elektronik; 14 Expédition; immédiate; 647-UWT1V221MNL1S; UWT1V221MNL1GS; Nichicon; Condensateurs électrolytiques en aluminium - CMS 35volts 220uF AEC-Q200 RoHS : conforme; Conditionnement: **Bande coupée; 20 Expédition; 757-TB67H450FNGEL; TB67H450FNG,EL; Toshiba; 15 Expédition; Bourns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

Embases et
logements de
câbles WR-BHD
2.54mm Box 20Pin
Male Angled
RoHS : conforme

Contrôleurs et
pilotes de moteur /
de mouvement /
d'allumage
MOTOR DRIVER

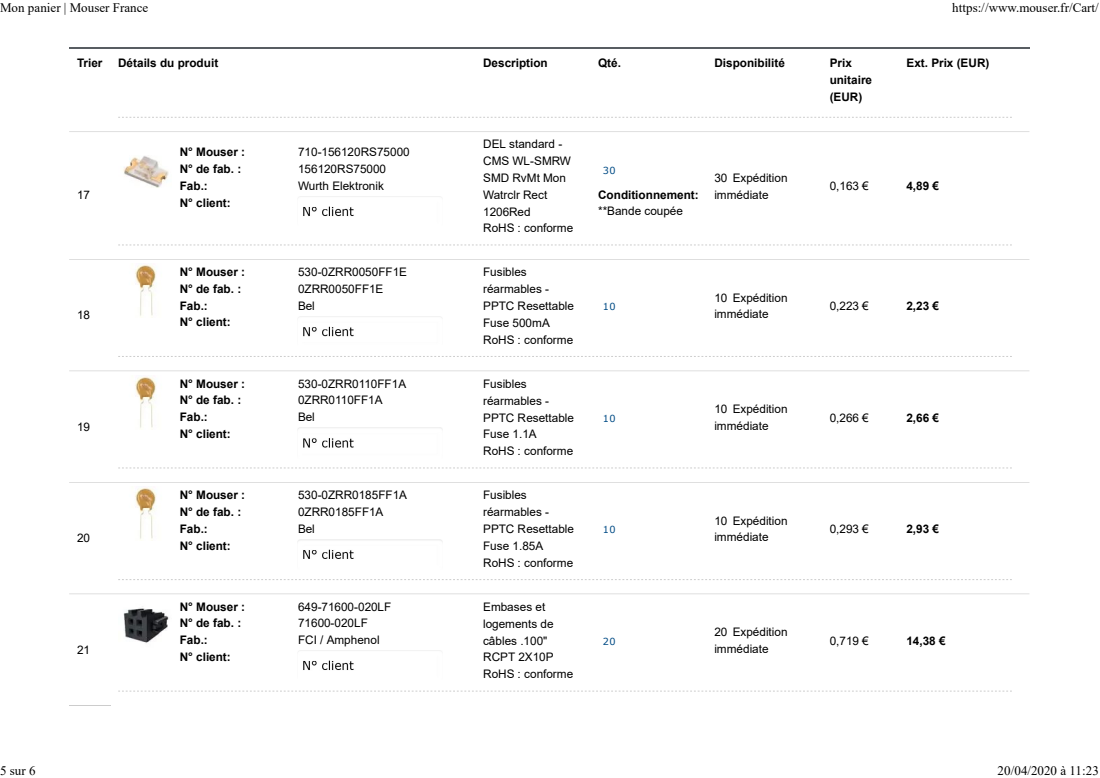
[picture p40: page 5]
unitaire (EUR); N° Mouser :; N° de fab. :; Fab.:; Wurth Elektronik; N° client:; Conditionnement: **Bande coupée; 30 Expédition; immédiate; 530-0ZRR0050FF1E; 0ZRR0050FF1E; Bel; Fusibles réarmables - PPTC Resettable Fuse 500mA RoHS : conforme; 10 Expédition; 530-0ZRR0110FF1A; 0ZRR0110FF1A; Fusibles réarmables - PPTC Resettable Fuse 1.1A RoHS : conforme; 530-0ZRR0185FF1A; 0ZRR0185FF1A; Fusibles réarmables - PPTC Resettable Fuse 1.85A RoHS : conforme; FCI / Amphenol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

DEL standard -
CMS WL-SMRW
SMD RvMt Mon
Watrclr Rect
1206Red
RoHS : conforme

unitaire
(EUR)

22

N° Mouser : | 495-TSR-1-2450
N° de fab. : | TSR 1-2450
Fab.: | TRACO Power
N° client:

Convertisseurs
CC-CC non isolés
Product Type:
POL; Package
Style: SIP; Output
Power (W): N/A;
Input Voltage:
6.5-36 VDC;
Output 1 (Vdc): 5;
Output 2 (Vdc):
N/A; Output 3
(Vdc): N/A
RoHS : conforme

7

### 7 Expédition

immédiate | 5,49 € | 38,43 €

En soumettant votre commande, vous acceptez ces conditions.
Pour plus d'informations sur la disponibilité, cliquez sur le numéro de référence Mouser

**Tous les articles MouseReel™ ne peuvent être ni annulés ni retournés.

Incoterms :DDP
Tous les prix incluent les taxes et les droits de douane pour les modes d'expédition sélectionnés.
Livraison gratuite pour la plupart des commandes supérieures à 50 € (EUR)
Total des articles : | | 249,65 €
Expédition : | FedEx International Priorité | 0,00 €
| + Autres options de livraison
Sous-total : | | 249,65 €
6 sur 6 | 20/04/2020 à 11:23
