INSA-GEI/Voilier/docs/SysML/Ibd_ElectroniqueVoilier.pdf

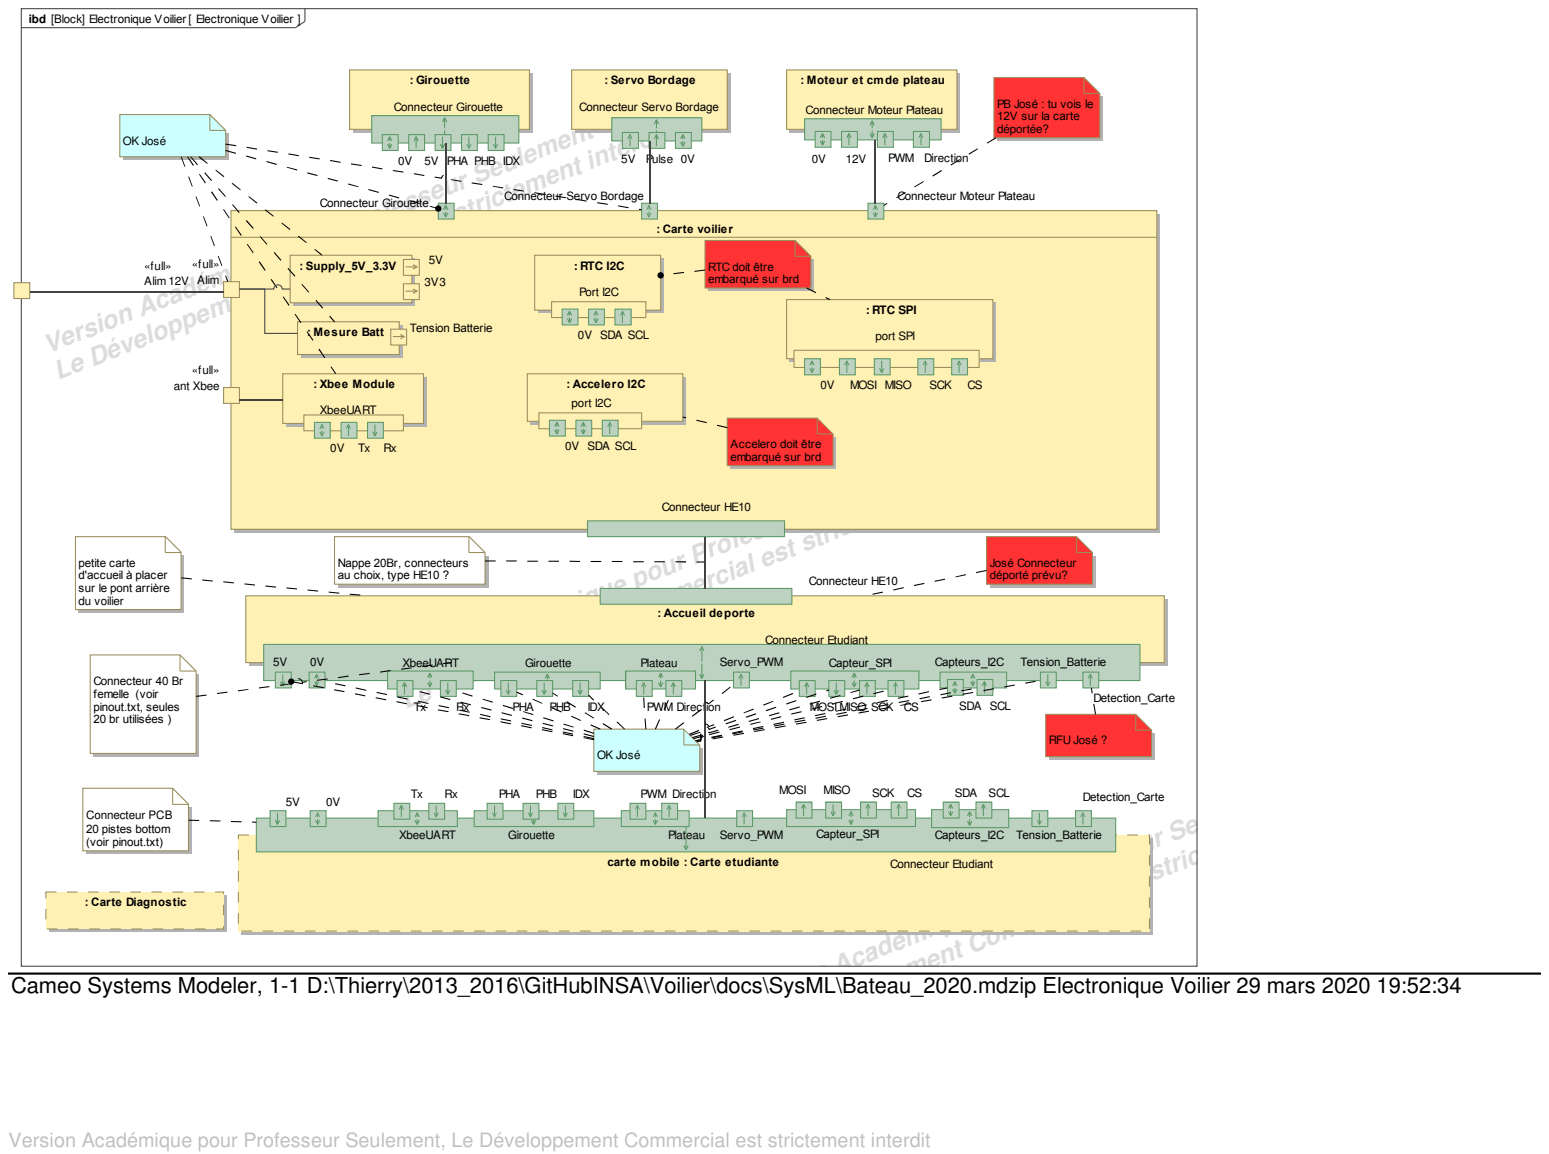
[picture p41: page 1]
ibd [Block] Electronique Voilier Electronique Voilier [; «full» Alim 12V; : RTC SPI; MOSI MISO; SCK; port SPI; : Accelero I2C; 0V SDA SCL; port I2C; : Xbee Module; XbeeUART; : RTC I2C; Port I2C; : Supply_5V_3.3V; : Mesure Batt; Tension Batterie; : Carte voilier; Connecteur HE10; Connecteur Servo Bordage; Connecteur Moteur Plateau Connecteur Girouette; «full» ant Xbee; «full» Alim; : Accueil deporte; Capteur_SPI; PHA; PHB; IDX; Girouette; PWM Direction; Plateau; SDA SCL; Servo_PWM; Capteurs_I2C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

: Moteur et cmde plateau

PB José : tu vois le
12V sur la carte
déportée?

Connecteur Servo Bordage

Connecteur Moteur Plateau

Version Académique pour Professeur Seulement

Le Développement Commercial est strictement interdit

RTC doit être
embarqué sur brd

Accelero doit être

petite carte
d'accueil à placer
sur le pont arrière
du voilier

Nappe 20Br, connecteurs
au choix, type HE10 ?

Connecteur 40 Br
femelle (voir
pinout.txt, seules
20 br utilisées )

MOSI MISO SCK CS

Connecteur PCB
20 pistes bottom
(voir pinout.txt)

Académique pour Professeur Seu

ment Commercial est strict
Connecteur Etudiant

carte mobile : Carte etudiante

Cameo Systems Modeler, 1-1 D:\Thierry\2013_2016\GitHubINSA\Voilier\docs\SysML\Bateau_2020.mdzip Electronique Voilier 29 mars 2020 19:52:34

Version Académique pour Professeur Seulement, Le Développement Commercial est strictement interdit
