INSA-GEI/Voilier/docs/SysML/Bdd_Systeme_Technique_Voilier.pdf

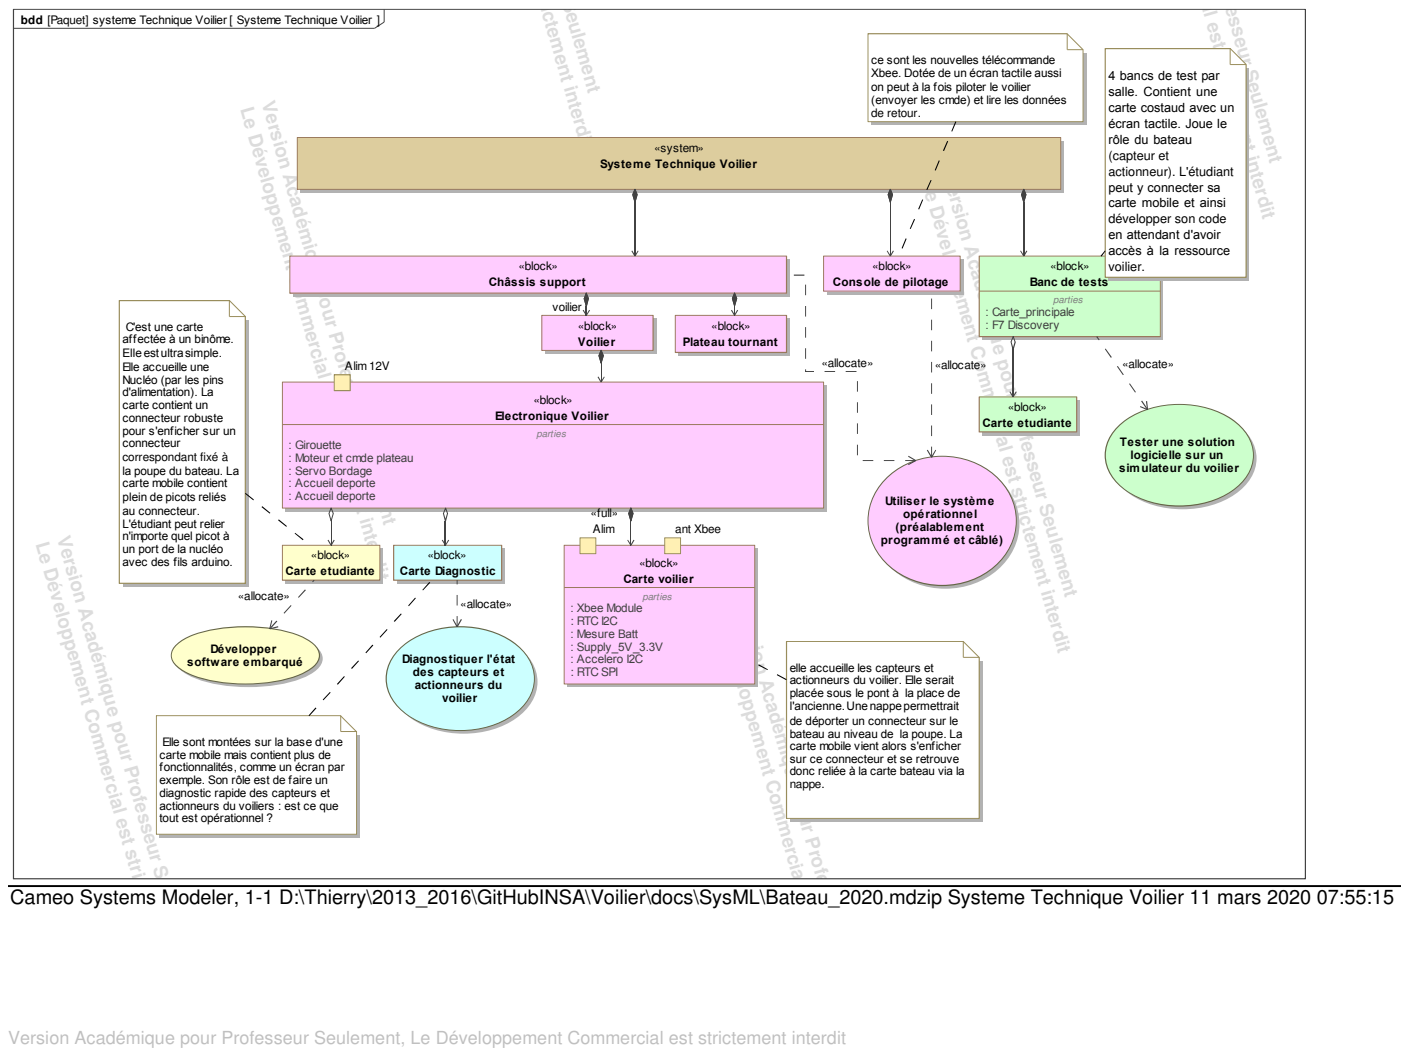
[picture p42: page 1]
esseur Seulement; Version Académique; Seulement ictement interdit; pour Profe; Le Développement Commercial; pour Professeur S; «system»; parties; Electronique Voilier; «block»; Alim 12V; «block» Châssis support; : RTC SPI; : Accelero I2C; : Xbee Module; : Supply_5V_3.3V; : RTC I2C : Mesure Batt; Carte voilier; ant Xbee; «full» Alim; : F7 Discovery; : Carte_principale; Développer; software embarqué; Diagnostiquer l'état; «block» Voilier; «block» Plateau tournant; Carte Diagnostic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

al est strictement interdit

bdd [Paquet] systeme Technique Voilier [ Systeme Technique Voilier ]

ce sont les nouvelles télécommande
Xbee. Dotée de un écran tactile aussi
on peut à la fois piloter le voilier
(envoyer les cmde) et lire les données
de retour.

4 bancs de test par
salle. Contient une
carte costaud avec un
écran tactile. Joue le
rôle du bateau
(capteur et
actionneur). L'étudiant
peut y connecter sa
carte mobile et ainsi
développer son code
en attendant d'avoir
accès à la ressource
voilier.

Développement Commercial est strictement interdit

Systeme Technique Voilier

«block»
Banc de tests

pour Professeur Seulement

Console de pilotage

C'est une carte
affectée à un binôme.
Elle est ultra simple.
Elle accueille une
Nucléo (par les pins
d'alimentation). La
carte contient un
connecteur robuste
pour s'enficher sur un
connecteur
correspondant fixé à
la poupe du bateau. La
carte mobile contient
plein de picots reliés
au connecteur.
L'étudiant peut relier
n'importe quel picot à
un port de la nucléo
avec des fils arduino.

: Girouette
: Moteur et cmde plateau
: Servo Bordage
: Accueil deporte

Tester une solution
logicielle sur un
simulateur du voilier

Utiliser le système
opérationnel
(préalablement
programmé et câblé)

Développement Commercial est stri

des capteurs et
actionneurs du
voilier

elle accueille les capteurs et
actionneurs du voilier. Elle serait
placée sous le pont à la place de
l'ancienne. Une nappe permettrait
de déporter un connecteur sur le
bateau au niveau de la poupe. La
carte mobile vient alors s'enficher
sur ce connecteur et se retrouve
donc reliée à la carte bateau via la
nappe.

Elle sont montées sur la base d'une
carte mobile mais contient plus de
fonctionnalités, comme un écran par
exemple. Son rôle est de faire un
diagnostic rapide des capteurs et
actionneurs du voiliers : est ce que
tout est opérationnel ?

Cameo Systems Modeler, 1-1 D:\Thierry\2013_2016\GitHubINSA\Voilier\docs\SysML\Bateau_2020.mdzip Systeme Technique Voilier 11 mars 2020 07:55:15

Version Académique pour Professeur Seulement, Le Développement Commercial est strictement interdit
