INSA-GEI/Voilier/pcb/carte_etudiant/PDF/carte_etudiant-B_Cu.pdf

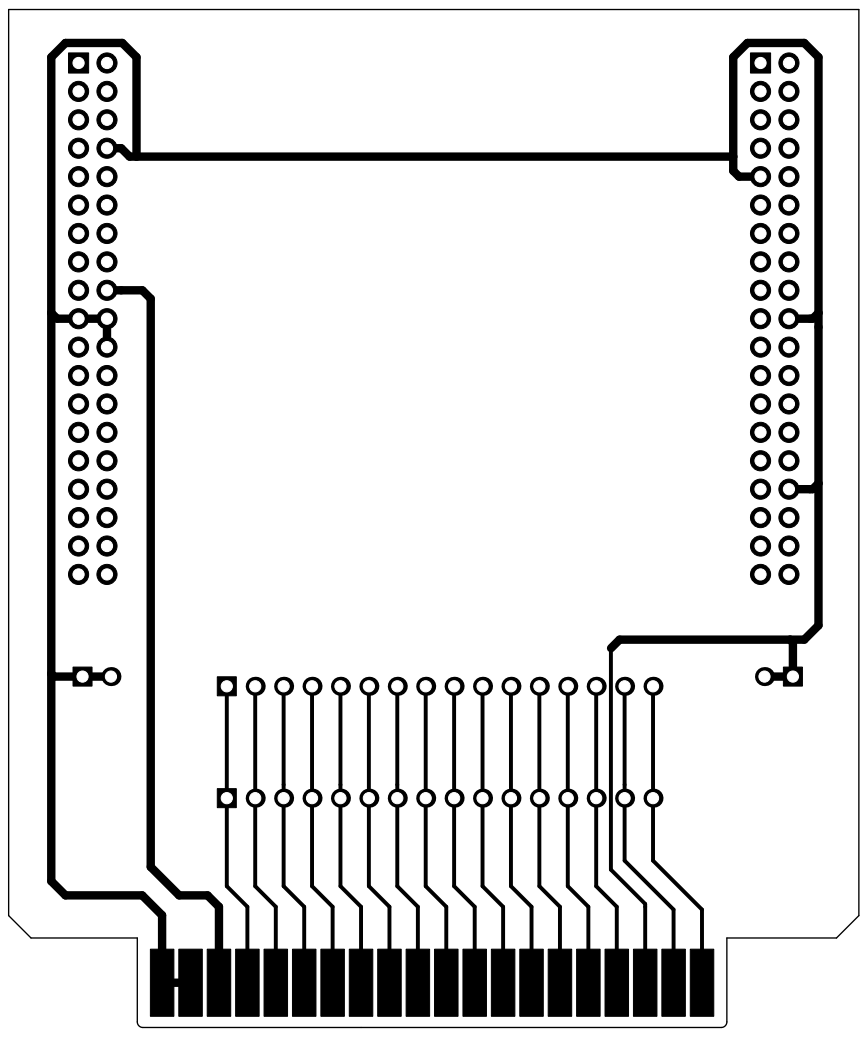
[picture p43: page 1]

INSA GEI
File: carte_etudiant.kicad_pcb Sheet:
Id: 1/1 Title: Carte etudiant
