INSA-GEI/Voilier/pcb/carte_etudiant/PDF/carte_etudiant-Edge_Cuts.pdf

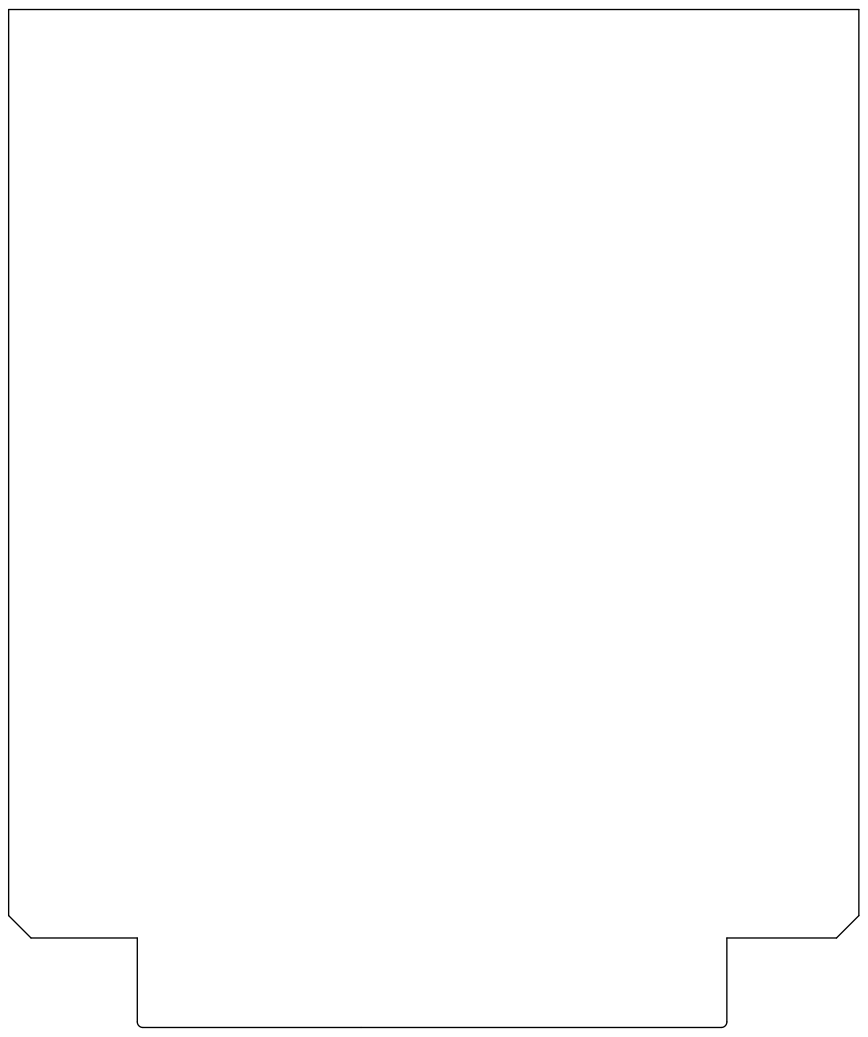
[picture p44: page 1]

INSA GEI
File: carte_etudiant.kicad_pcb Sheet:
Id: 1/1 Title: Carte etudiant
