INSA-GEI/Voilier/pcb/Carte_interface_voilier/PDF/interface_voilier_schema.pdf

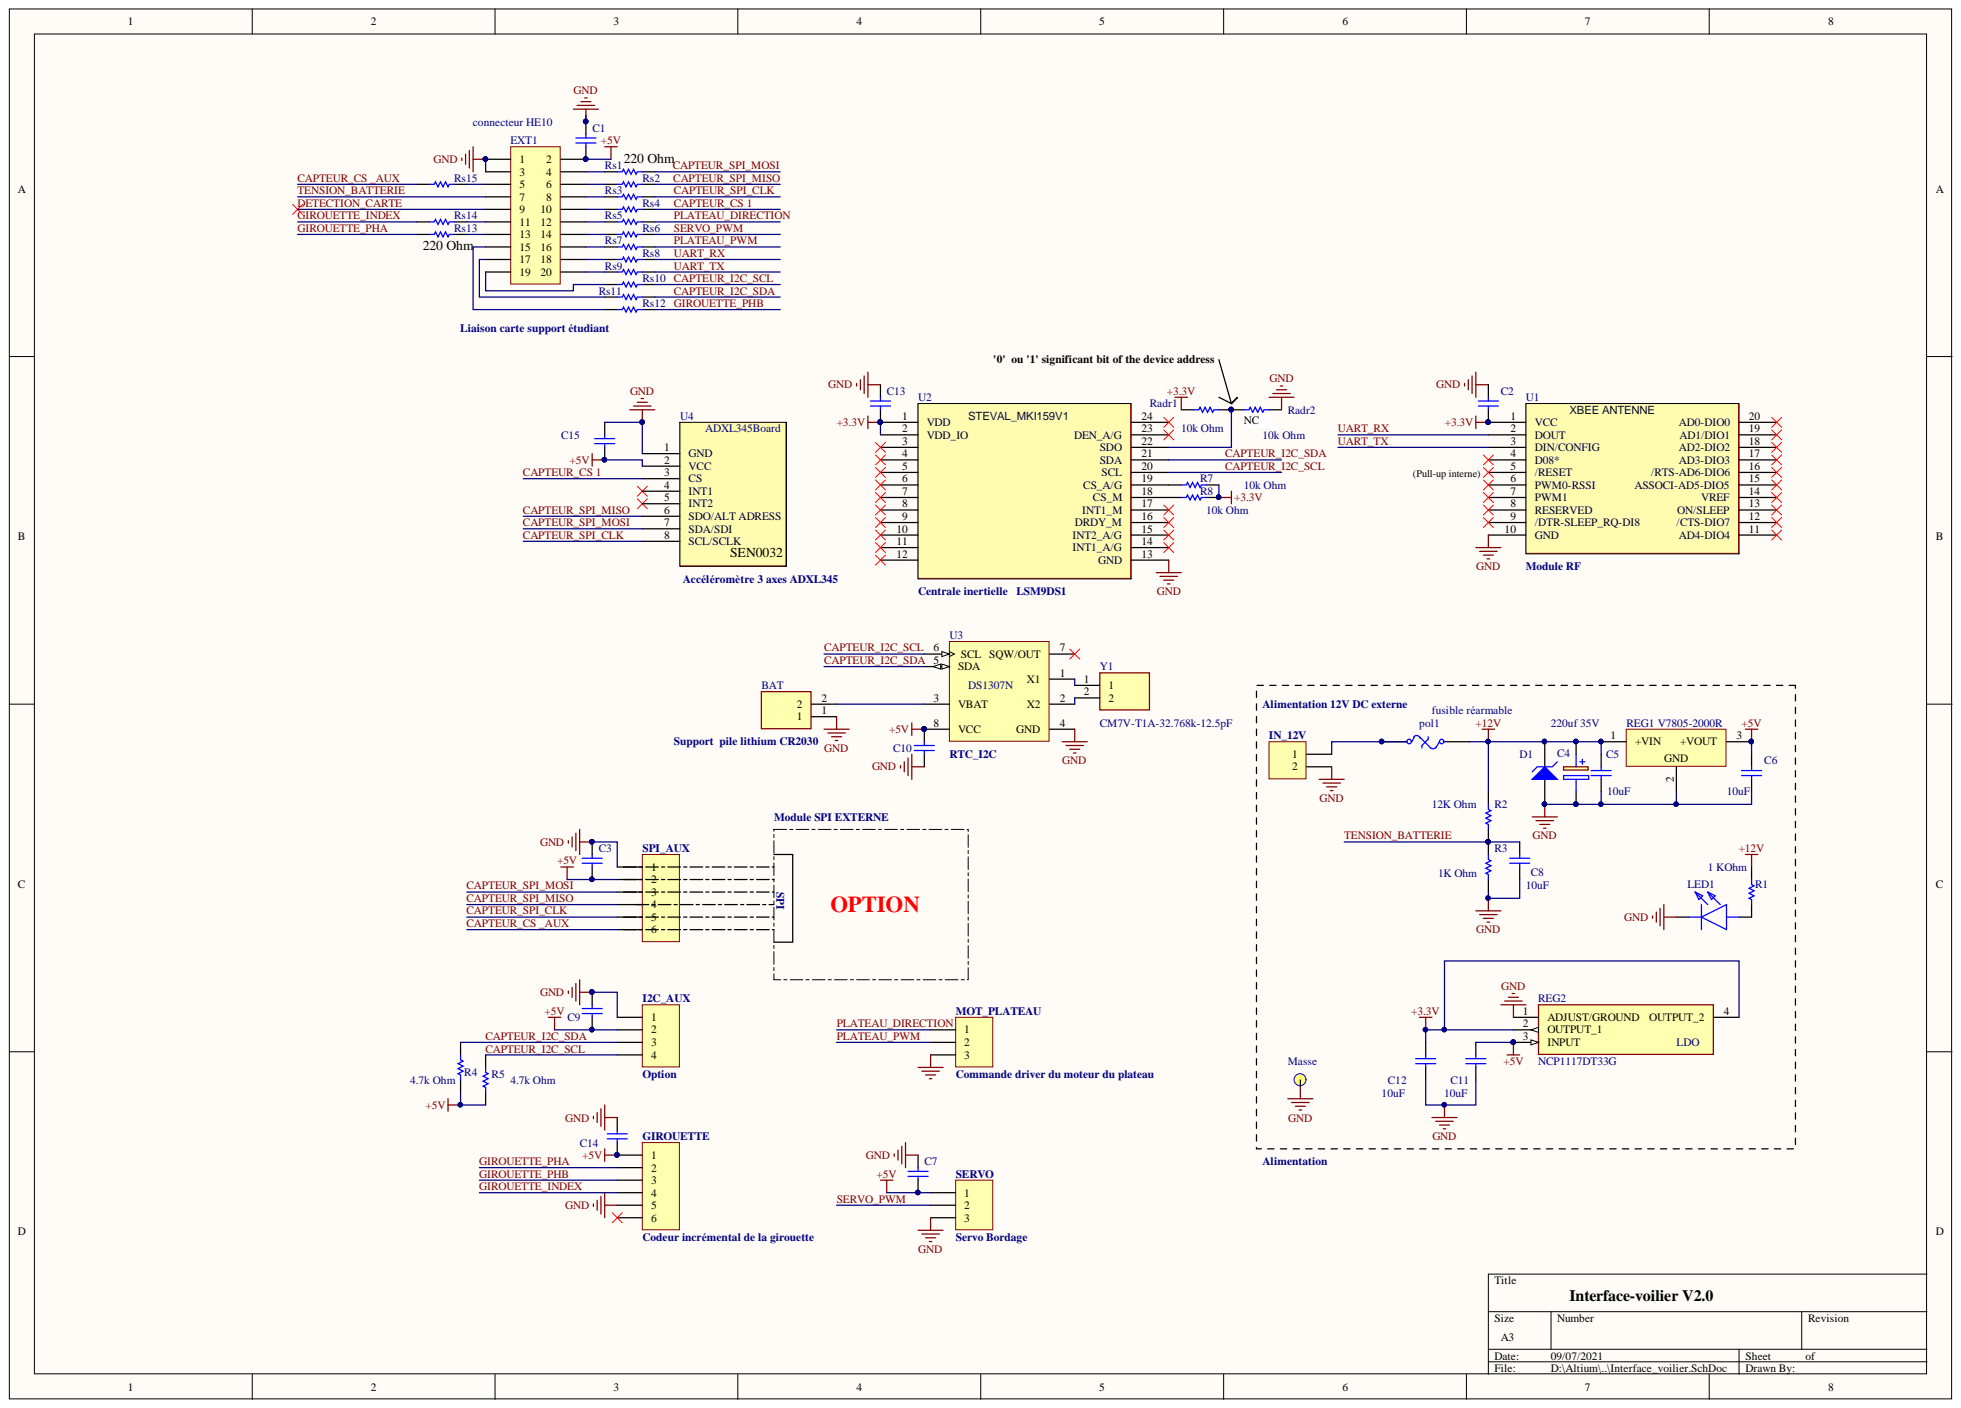
[picture p45: page 1]

17 18
19 20

Liaison carte support étudiant

'0' ou '1' significant bit of the device address

Support pile lithium CR2030 GND

4 5
