INSA-GEI/Voilier/pcb/Carte_driver_moteur_plateau/PDF/driver_moteur_schema.pdf

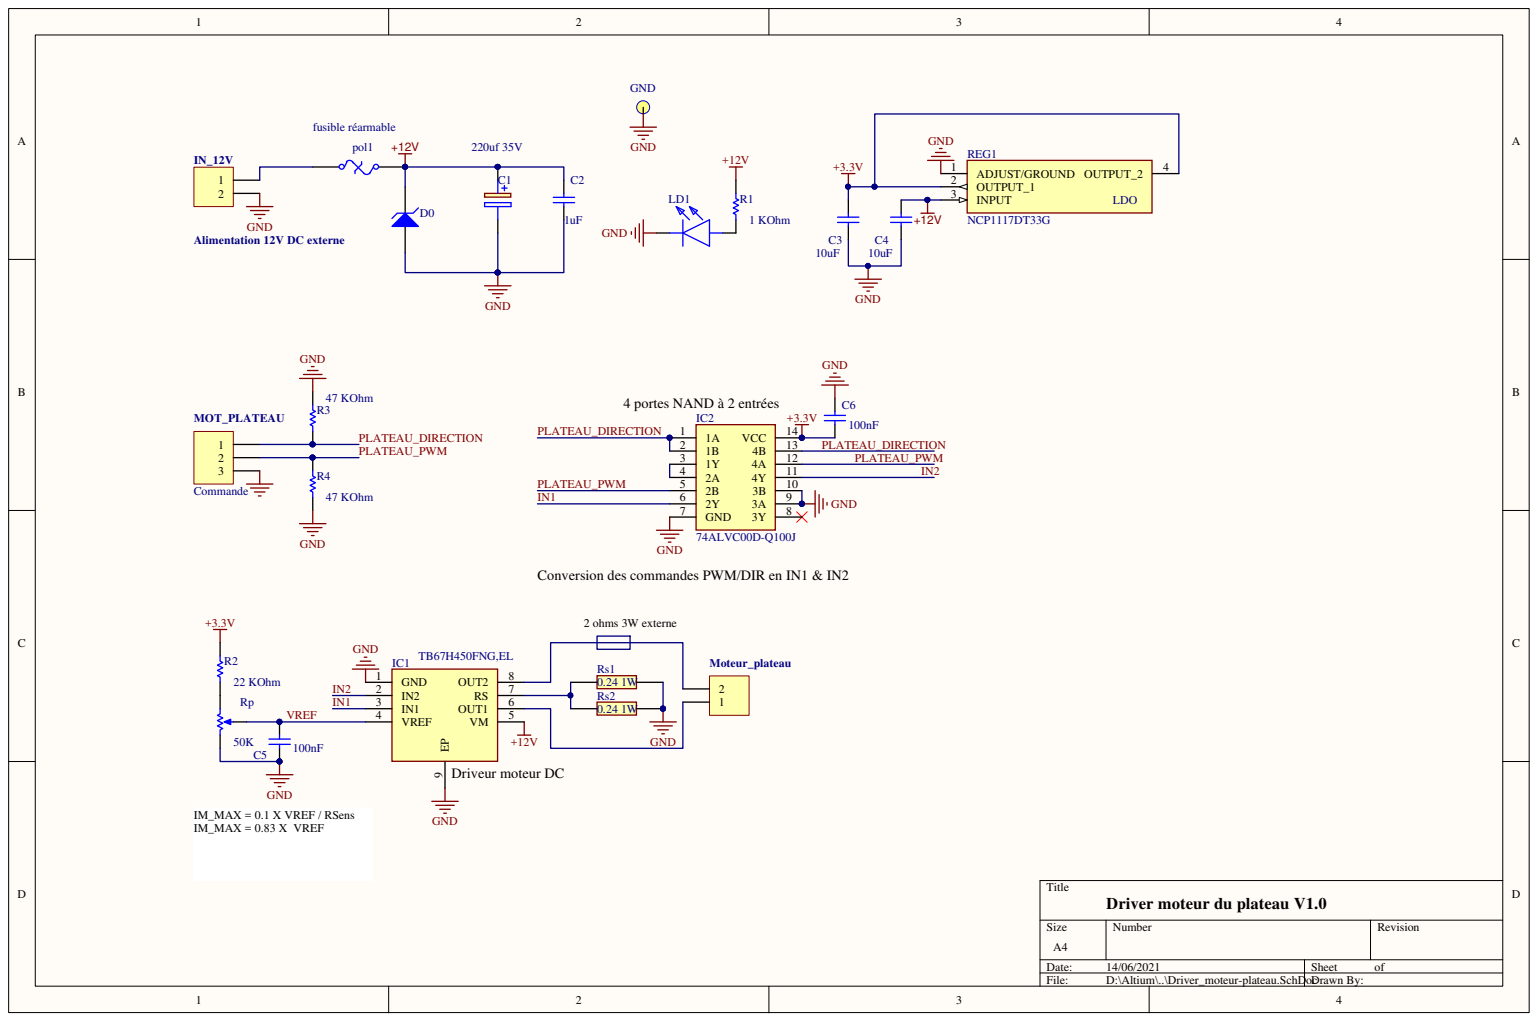
[picture p46: page 1]

Conversion des commandes PWM/DIR en IN1 & IN2

Driver moteur du plateau V1.0
