INSA-GEI/Voilier/pcb/Carte_telecommande_voilier/PDF/Schematic_carte_telecommande.pdf

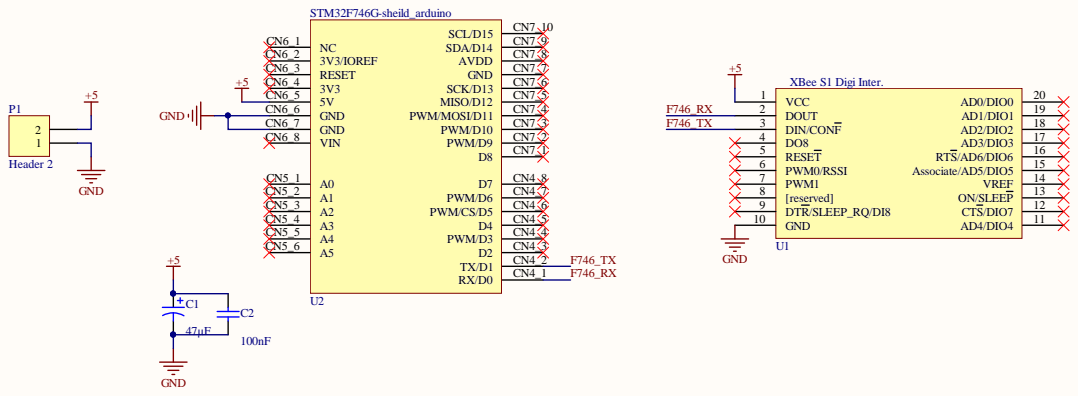
[picture p47: page 1]
