INSA-GEI/Voilier/docs/SysML/UseCase Systeme Complet.pdf

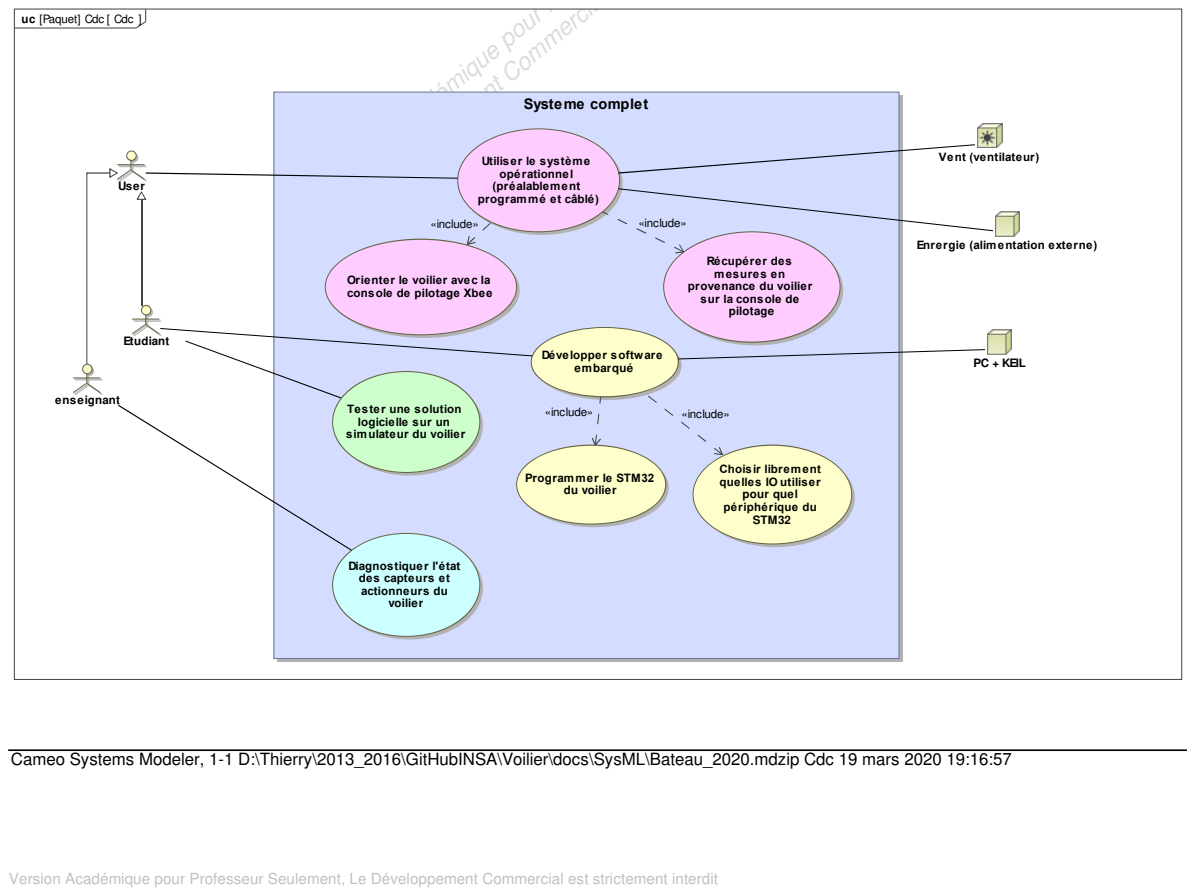
[picture p48: page 1]
uc [Paquet]; Cdc Cdc [; Systeme complet; Programmer le STM32 du voilier; Développer software embarqué; Vent (ventilateur); PC + KEIL; Etudiant; enseignant; User; «include»

Version Académique pour

Le Développement Commerci

Utiliser le système
opérationnel
(préalablement
programmé et câblé)

Enrergie (alimentation externe)

Récupérer des
mesures en
provenance du voilier
sur la console de
pilotage

Orienter le voilier avec la
console de pilotage Xbee

Le Développement Commercial est strictement interdit

Version Académique pour Professeur Seulement

Tester une solution
logicielle sur un
simulateur du voilier

Choisir librement
quelles IO utiliser
pour quel
périphérique du
STM32

Diagnostiquer l'état
des capteurs et
actionneurs du
voilier

Cameo Systems Modeler, 1-1 D:\Thierry\2013_2016\GitHubINSA\Voilier\docs\SysML\Bateau_2020.mdzip Cdc 19 mars 2020 19:16:57

Version Académique pour Professeur Seulement, Le Développement Commercial est strictement interdit
