INSA-GEI/Voilier/pcb/carte_etudiant/PDF/carte_etudiant.pdf

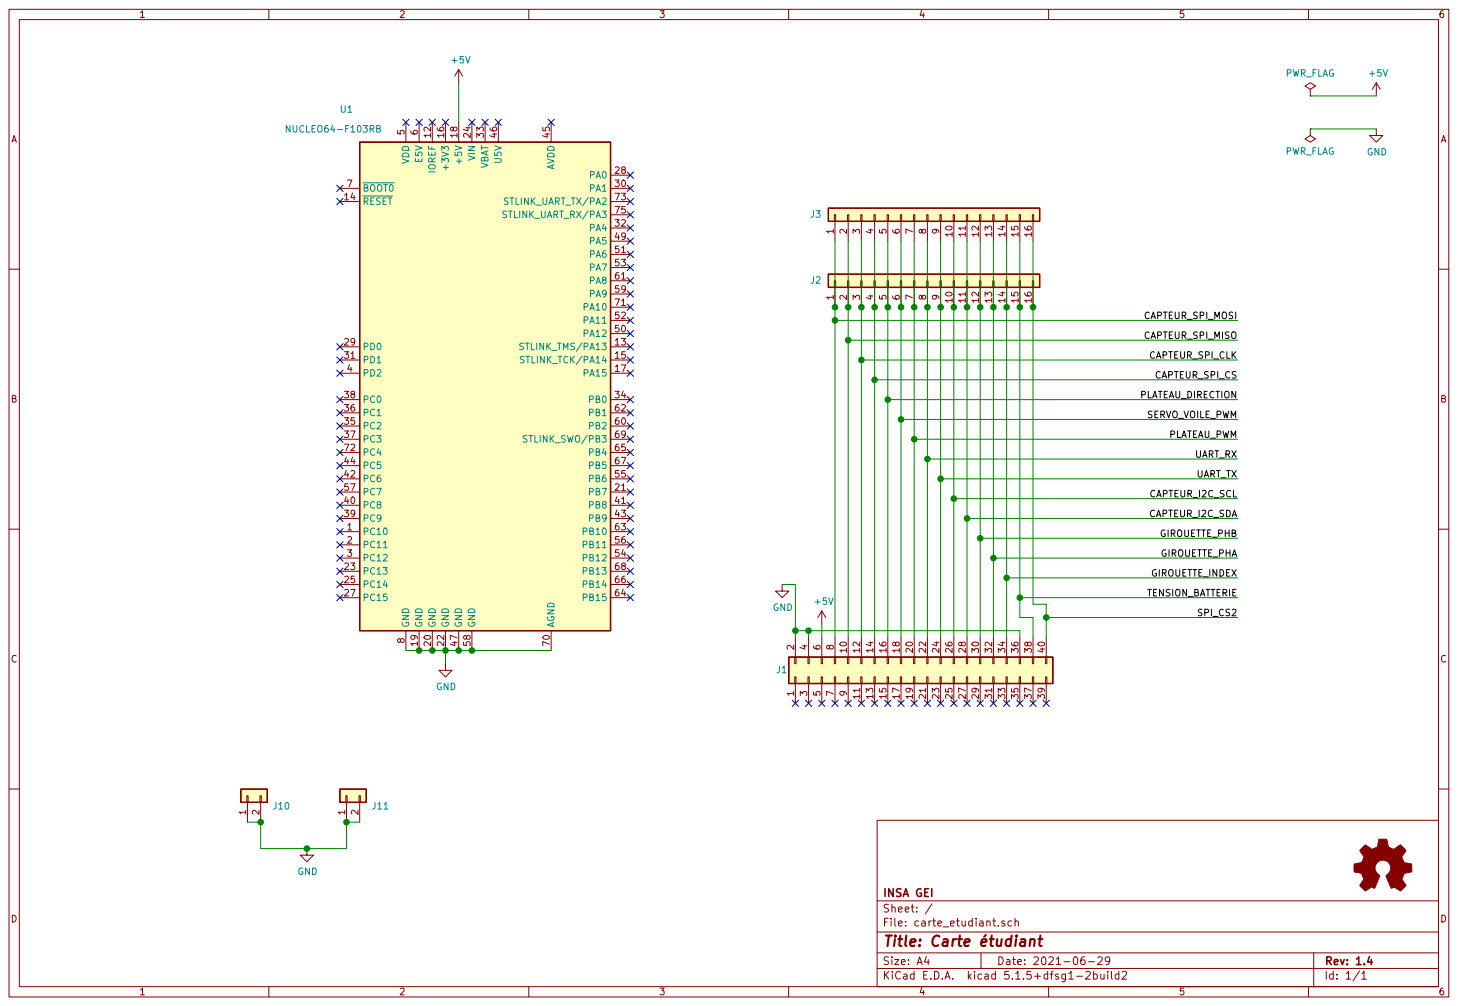
[picture p49: page 1]

File: carte_etudiant.sch Sheet: /
Id: 1/1 Title: Carte étudiant
