INSA-GEI/Voilier/pcb/Carte_interface_voilier/PDF/Interface_voilier_PCB.pdf

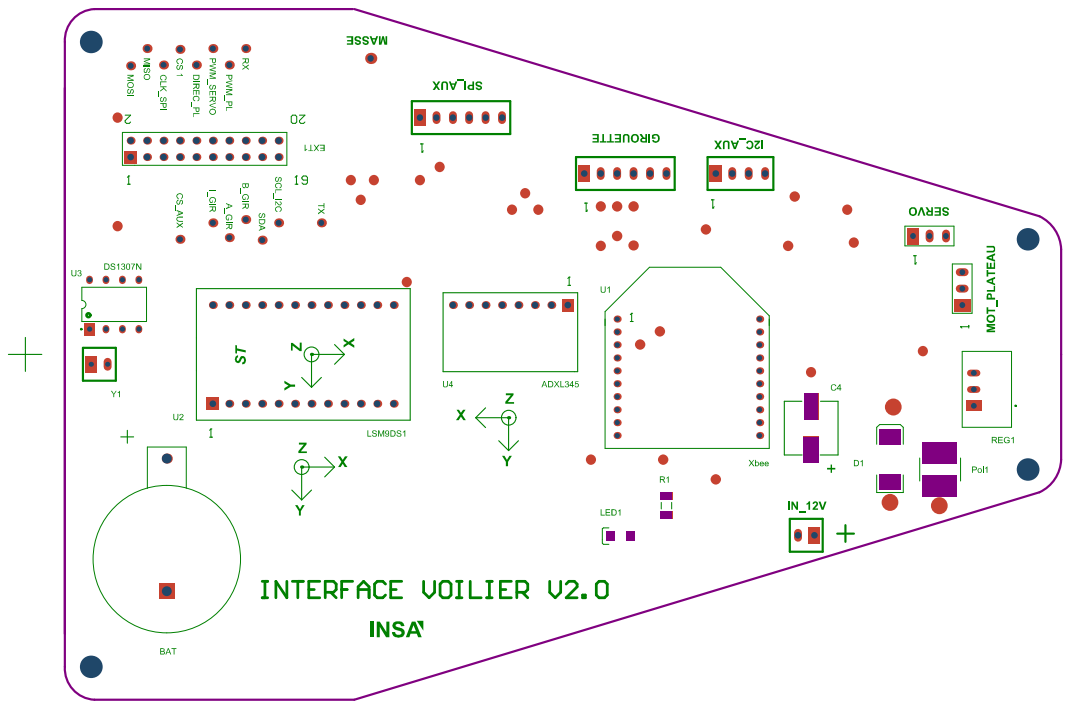
[picture p50: page 1]
