INSA-GEI/Voilier/pcb/carte_alim/PDF/Carte_alim_BOTTOM.pdf

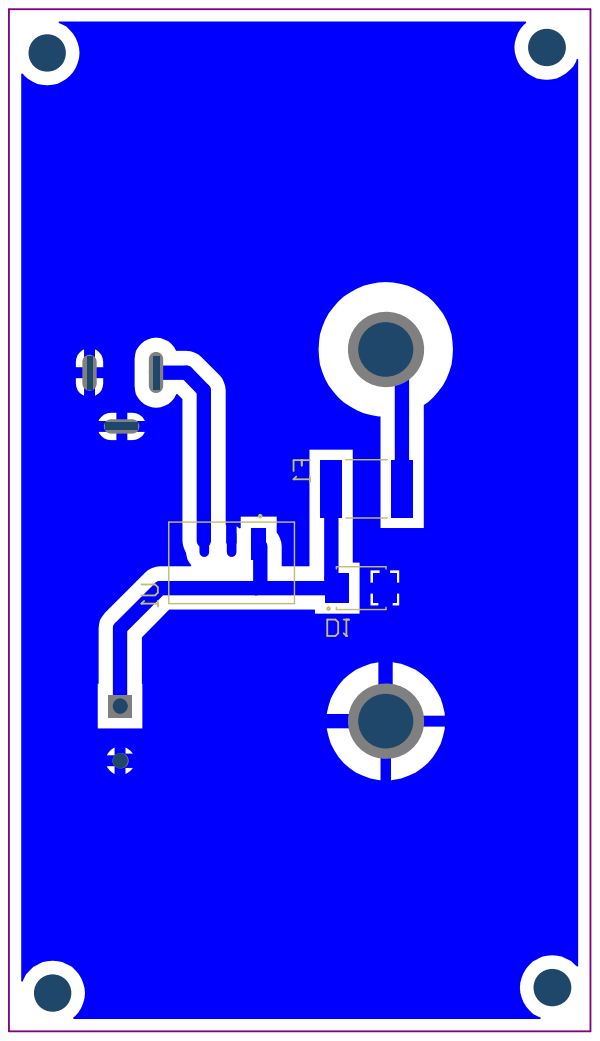
[picture p51: page 1]
