INSA-GEI/Voilier/pcb/Carte_driver_moteur_plateau/PDF/driver_moteur_pcb.pdf

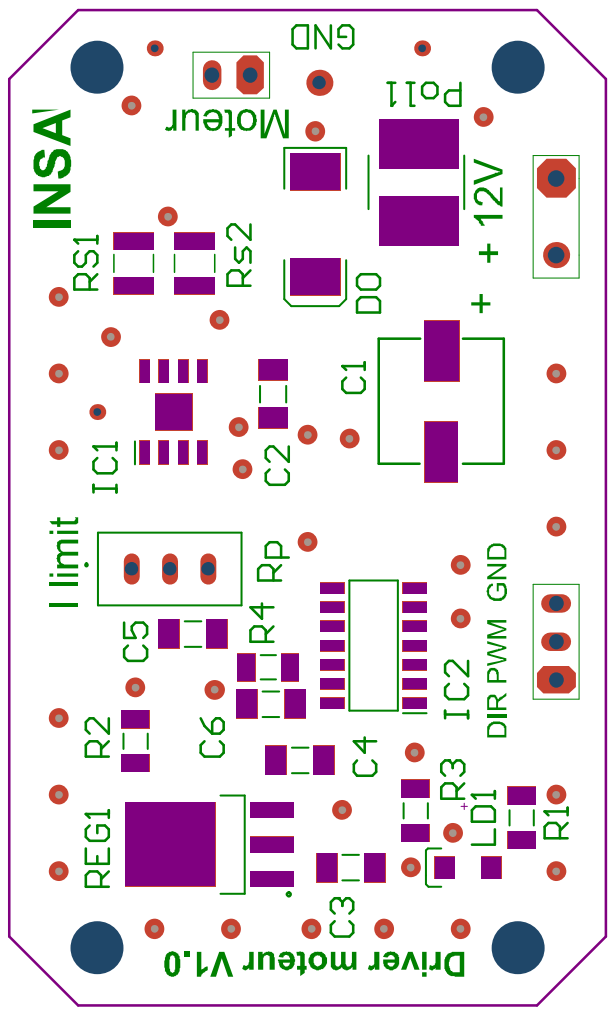
[picture p52: page 1]
