INSA-GEI/Voilier/pcb/pcb_accueil/PDF/pcb_accueil-B_Cu.pdf

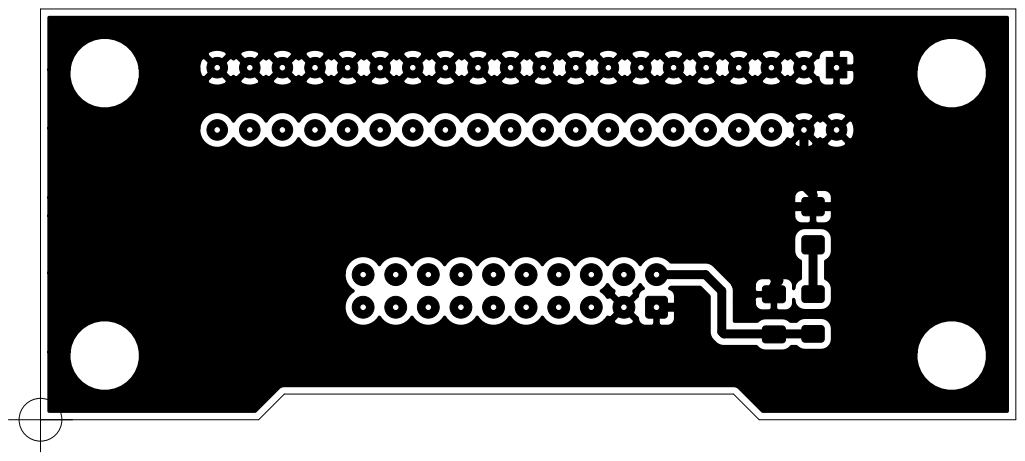
[picture p53: page 1]
