INSA-GEI/Voilier/pcb/pcb_accueil/PDF/pcb_accueil-B_SilkS.pdf

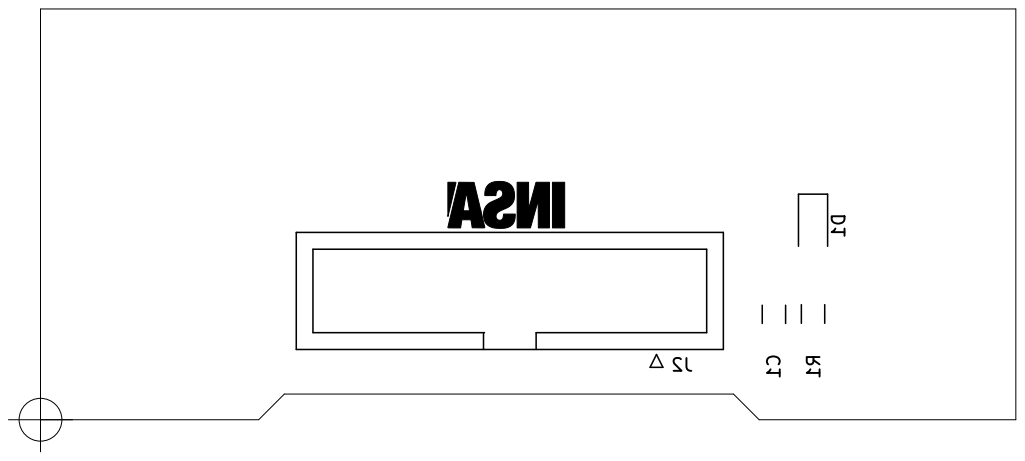
[picture p54: page 1]
