INSA-GEI/Voilier/pcb/pcb_accueil/PDF/pcb_accueil-Edge_Cuts.pdf

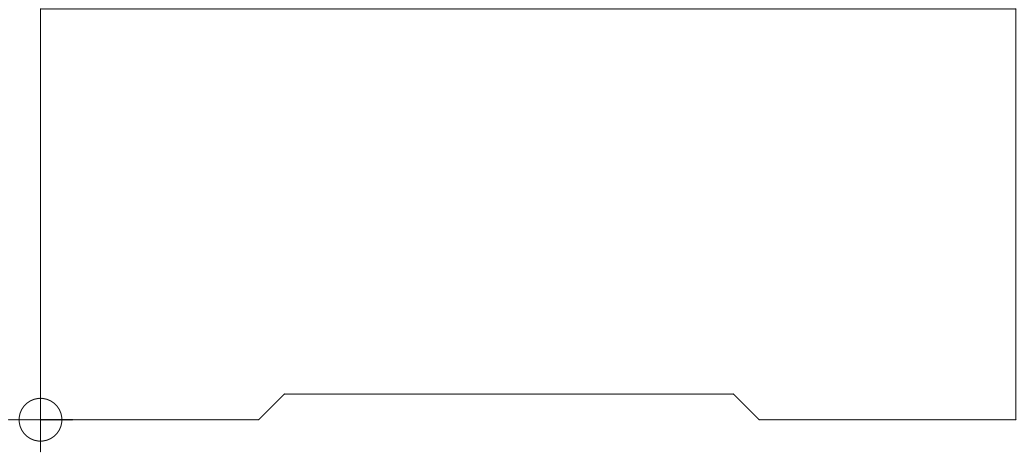
[picture p55: page 1]
