INSA-GEI/Voilier/pcb/pcb_accueil/PDF/pcb_accueil-F_Cu.pdf

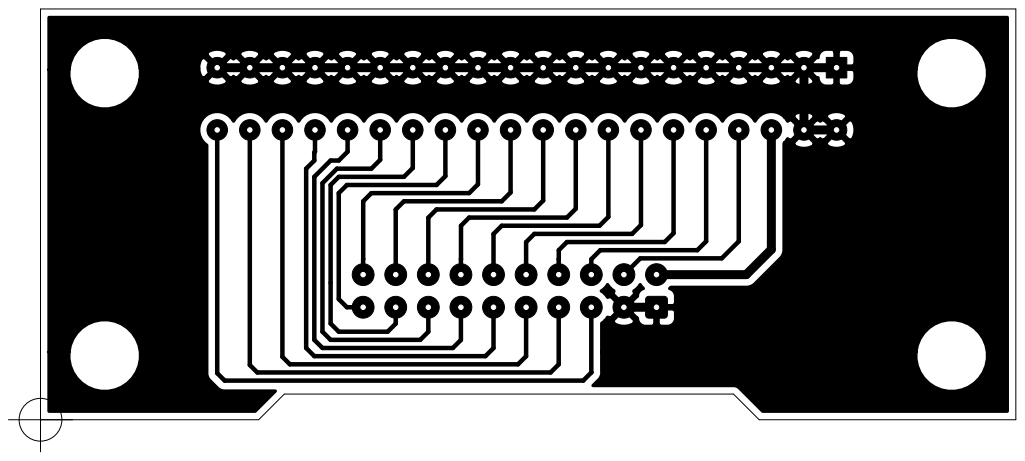
[picture p56: page 1]
