INSA-GEI/Voilier/pcb/pcb_accueil/PDF/pcb_accueil-F_SilkS.pdf

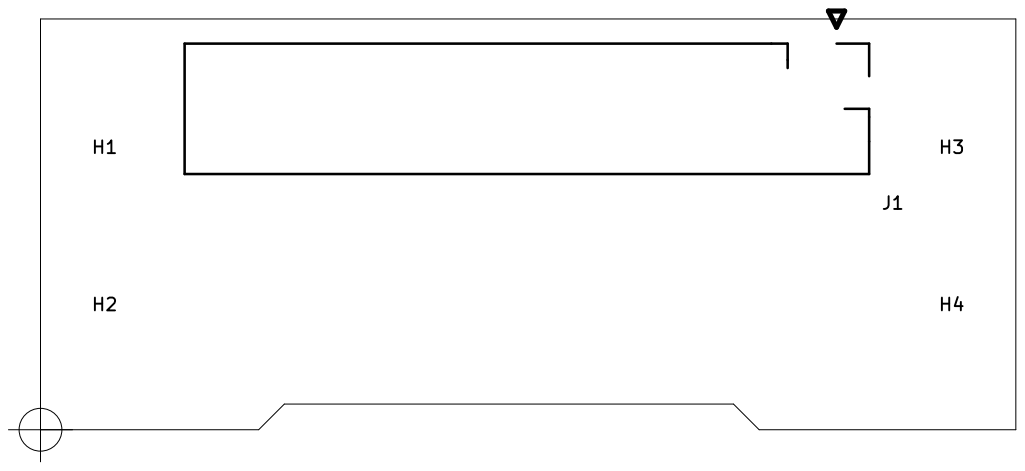
[picture p57: page 1]
