INSA-GEI/Voilier/pcb/pcb_accueil/PDF/pcb_accueil.pdf

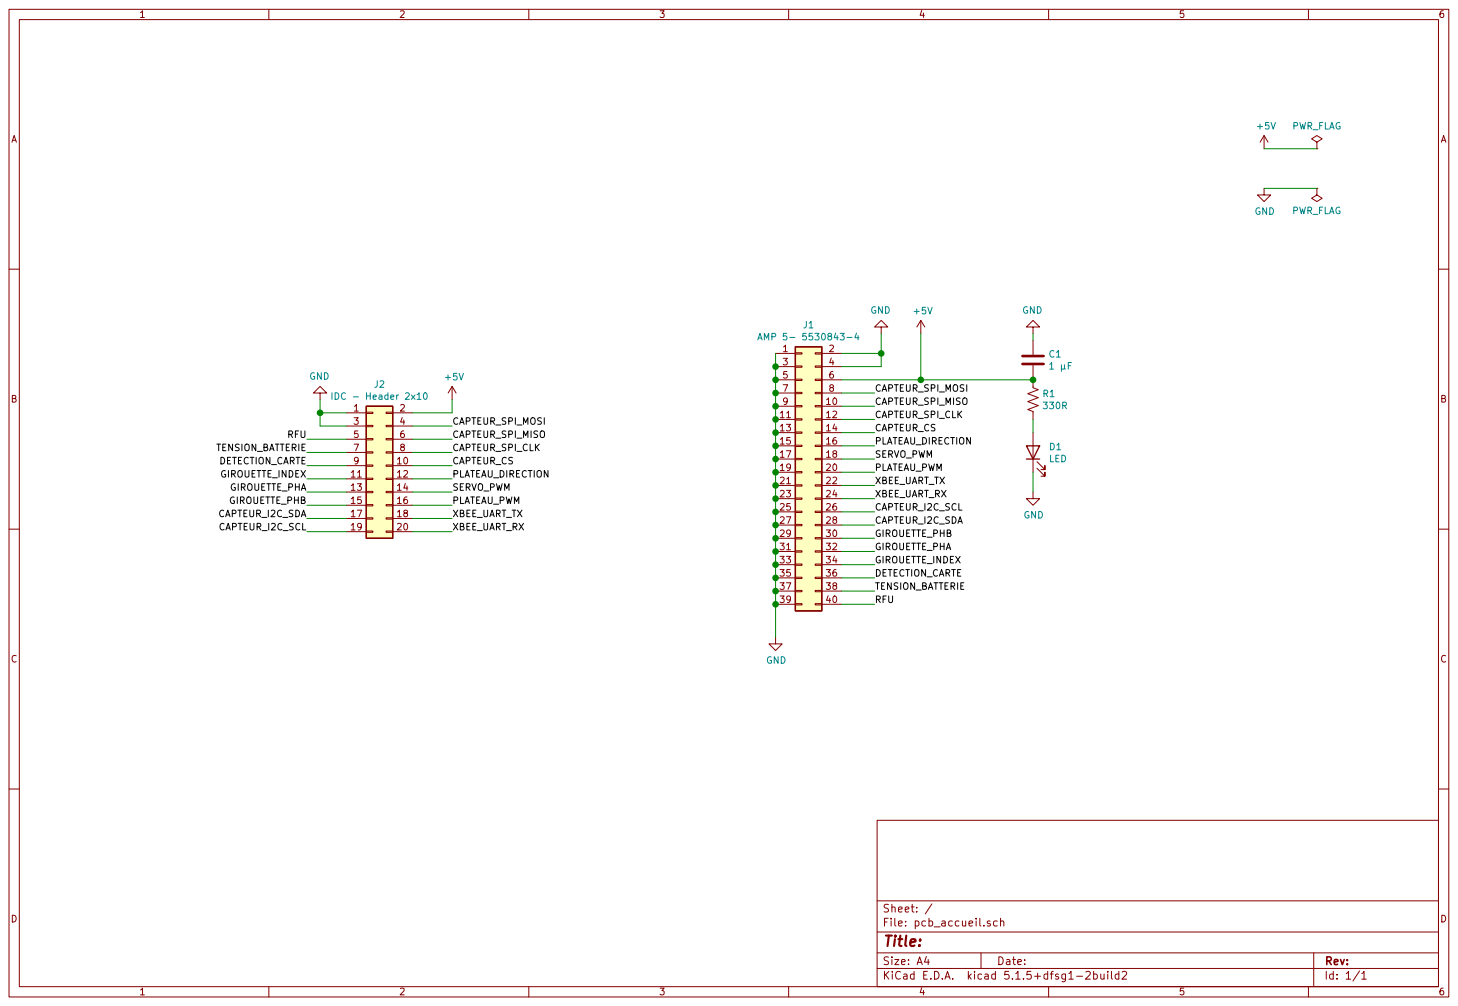
[picture p58: page 1]

13 | 14
15 | 16
17 | 18
19 | 20
21 | 22
