INSA-GEI/Voilier/pcb/Carte_telecommande_voilier/PDF/PCB_carte_telecommande.pdf

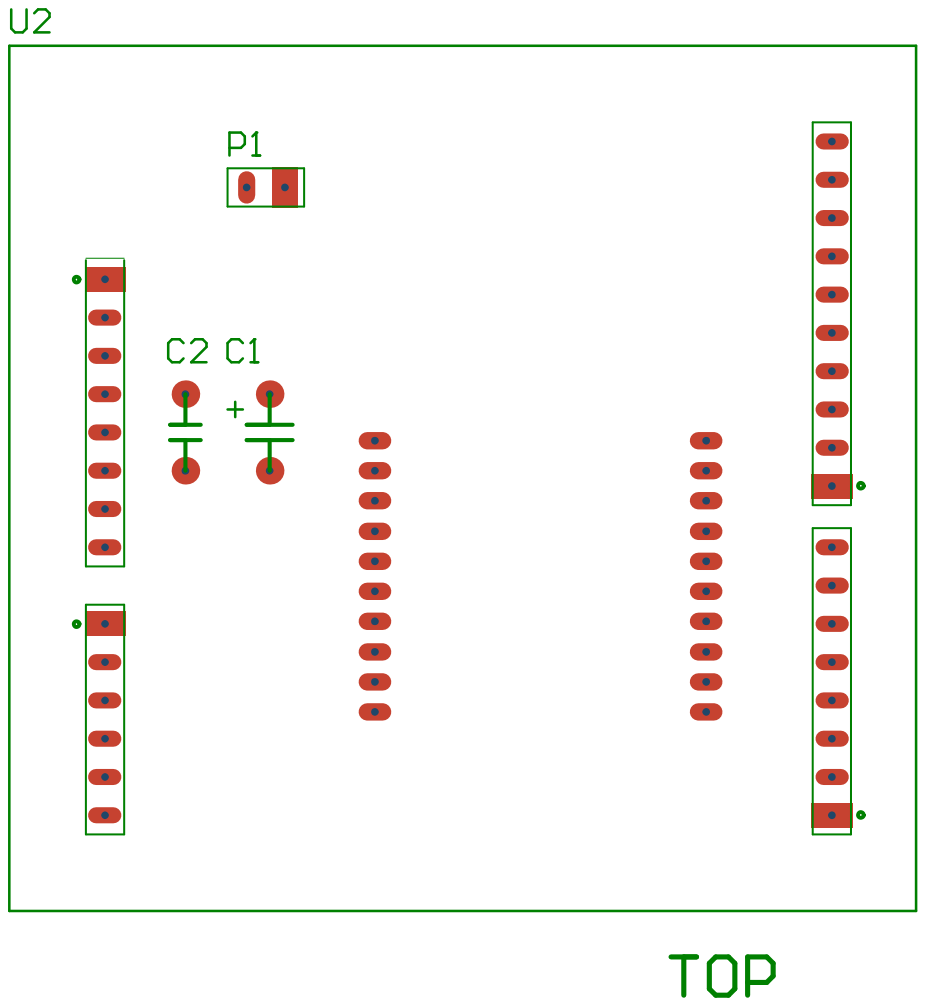
[picture p59: page 1]

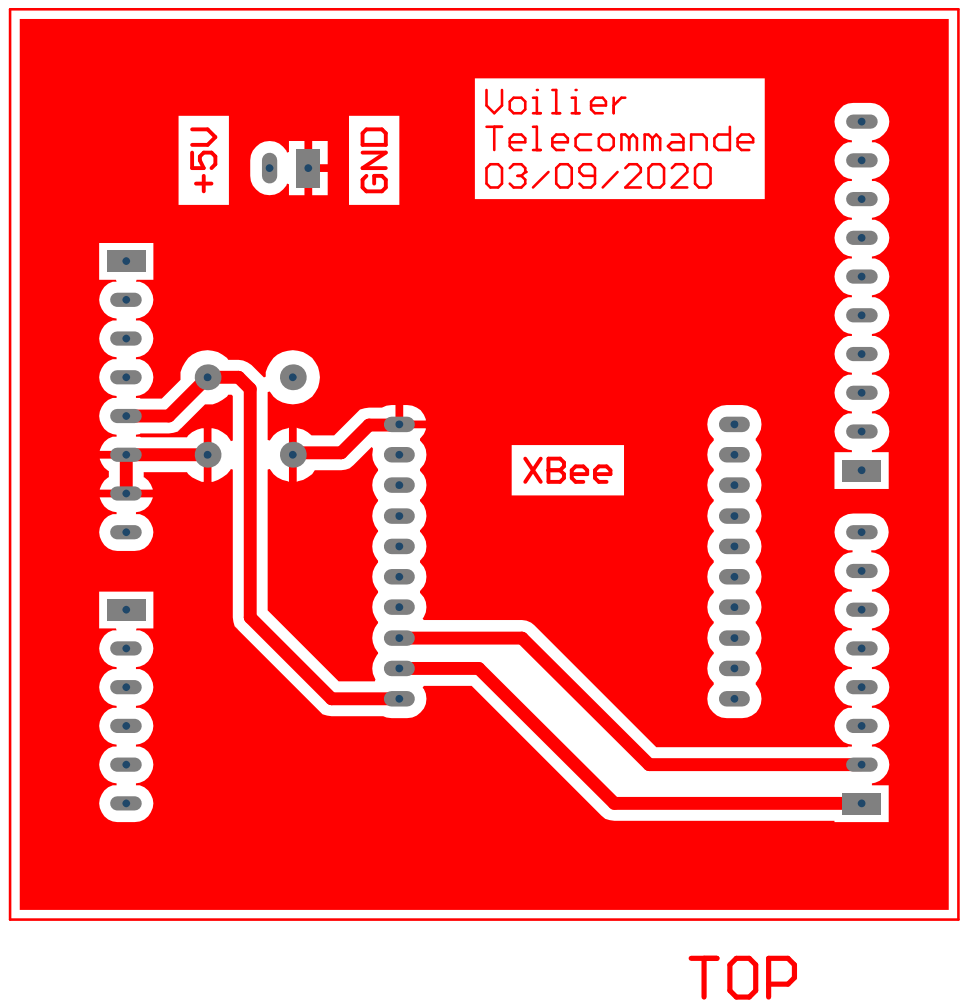
[picture p60: page 2]

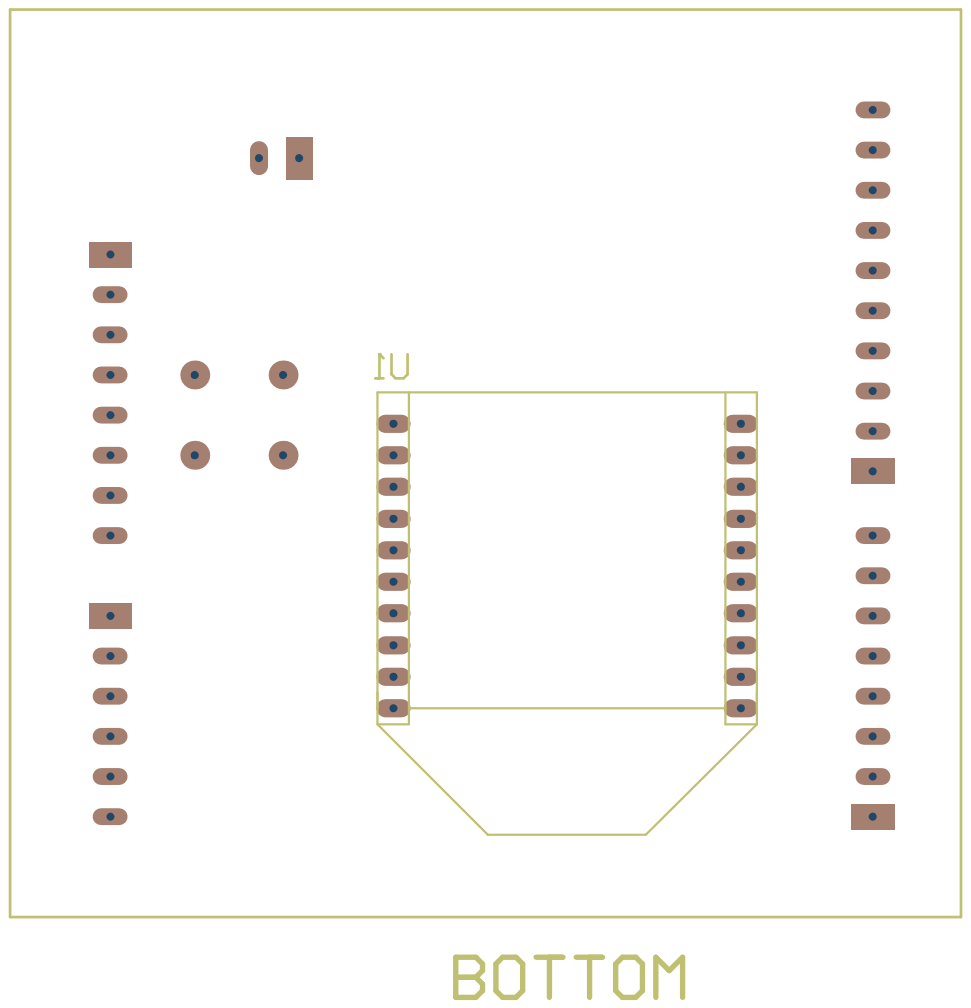
[picture p61: page 3]

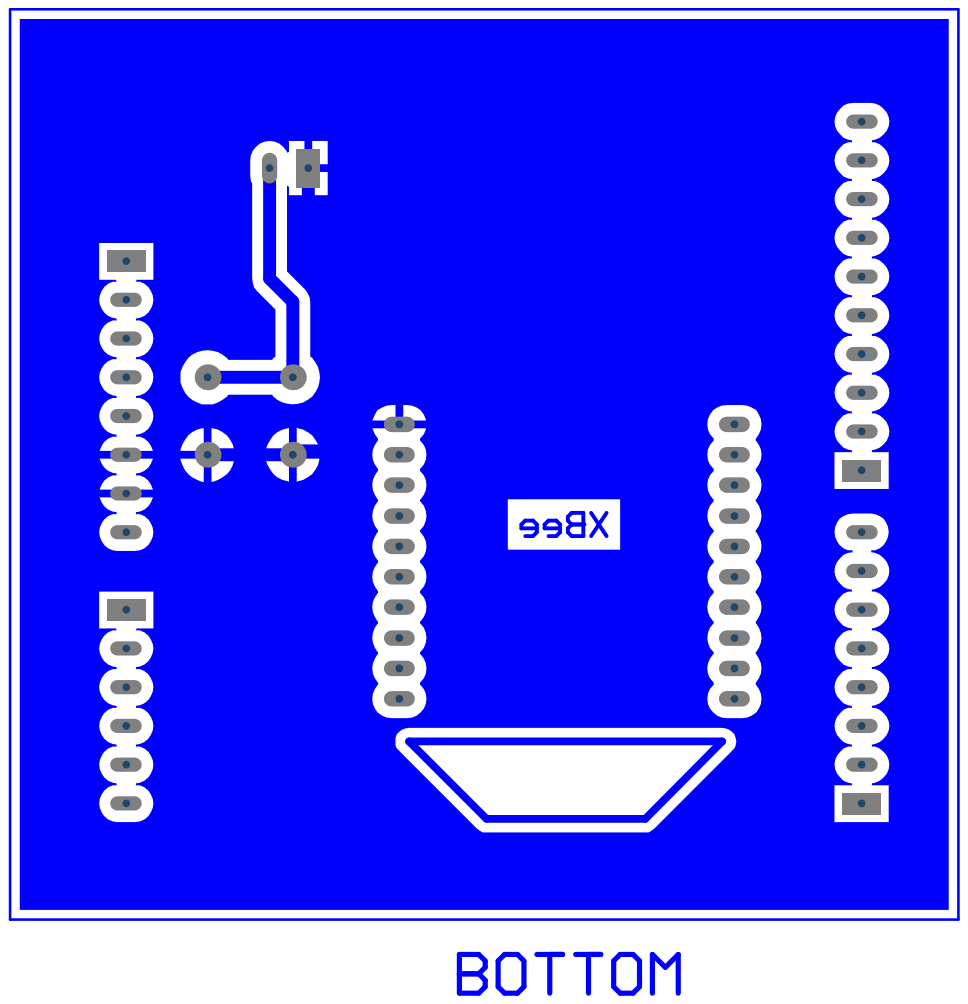
[picture p62: page 4]
