INSA-GEI/Voilier/(list of files, drawings)

Other design files:
meca/Telecommande/Voilier_telecom_boitier.PcbDoc
meca/Telecommande/Voilier_telecom_cadre.PcbDoc
pcb/carte_alim/Altium/Voilier_carte_alim.PcbDoc
pcb/carte_alim/Altium/Voilier_carte_alim.SchDoc
pcb/Carte_driver_moteur_plateau/Altium/Driver_moteur-plateau.SchDoc
pcb/Carte_driver_moteur_plateau/Altium/PCB_Driver_moteur_plateau.PcbDoc
pcb/Carte_interface_voilier/Altium/Interface_voilier.SchDoc
pcb/Carte_interface_voilier/Altium/PCB_Interface_voilier.PcbDoc
pcb/Carte_telecommande_voilier/Altium/Voilier_telecom.PcbDoc
pcb/Carte_telecommande_voilier/Altium/Voilier_telecom.SchDoc
