INSA-GEI/Voilier/(commit log)

2020-02-10 Chiffrage initial du projet
    [chiffrage_initial.ods]
2020-02-12 ajout de la requete comeq pour DD
2020-02-13 correction sur le chiffrage initial (quantité, type de PCB, ...)
    [chiffrage_initial.ods]
2020-02-14 Premier proto pour la carte etudiant
    [carte_etudiant.kicad_pcb, carte_etudiant.sch]
2020-03-04 deplacement du connecteur
    [carte_etudiant.kicad_pcb]
2020-03-06 Base de départ SysML. Use case fait, premier découpage grossier. Vu avec Seb
2020-03-09 avancement IO F7 Discovery, Use case Banc de test
2020-03-09 Connecteur Arduino OK, Sous blocs carte Principale OK, Interfaces Sysml uart, SPI, I2C avec req/fournis OK, reste à faire le connecteur vers carte etudiant
2020-03-10 l ibd du banc de test est terminé, a valider par seb, voir versio pdf
2020-03-10 Synchronisation du fichier docs/pinout.txt depuis la branche evo75-banc-de-tests-proto1: description du connecteur de la carte etudiant
2020-03-10 * Passage d un connecteur 30 pts à un connecteur 40 pts sur la carte etudiant * Correction sur le fichier de pinout (changement du nom du signal SERVO_PWM en SERVO_VOILE_PWM)
    [carte_etudiant.kicad_pcb, carte_etudiant.sch]
2020-03-10 * Export du schema de la carte en PDF
2020-03-11 idem mais pdf generes pour Seb et José, voir dans SysML, on trouve les deux ibd interessants
2020-03-13 * Elargisement des ouvertures autour du connecteur de carte, pour glisser plus facilement la carte
    [carte_etudiant.kicad_pcb]
2020-03-18 Premier jet du firmware de la console de pilotage (incluant l'interface graphique TouchGfx)
    [texts.xlsx]
2020-03-19 * IHM quasiement fini, reste les interactions à ecrire
    [texts.xlsx]
2020-03-24 * Dernier prototype de l'IHM, a valider par la team
    [texts.xlsx]
2020-03-24 * Rajout des bibliotheques touchGFX
2020-03-24 * Ajout des bibliotheques TouchGfx
2020-03-25 amélioration SysMl, notamment use case banc de test. Vu avec Seb oralement, mis en musique sur SysML
2020-03-29 comparaison ibd electronique voilier avec pdf Jose. Y a des couacs, il faut les resoudre
2020-04-02 * Creation des drivers uart et xbee en C++, avec une classe abstraite drivers pour gerer les interruptions
2020-04-03 ajout des fichiers Altium
    [Interface_ext_voilier_min.SchDoc, Interface_voilier.SchDoc, PCB_Interface_voilier.PcbDoc, PCB_extension_min.PcbDoc]
2020-04-09 Retour au C pour les drivers
2020-04-14 Intégration du RTC sur carte interface voilier
    [Interface_voilier.SchDoc, PCB_Interface_voilier.PcbDoc]
2020-04-16 ajout de la carte driver moteur du plateau
    [Driver_moteur-plateau.SchDoc, PCB_Driver_moteur_plateau.PcbDoc]
2020-04-17 corrections des empreintes et commande Mouser
    [Driver_moteur-plateau.SchDoc, Interface_ext_voilier_min.SchDoc, Interface_voilier.SchDoc, PCB_Driver_moteur_plateau.PcbDoc, PCB_Interface_voilier.PcbDoc, PCB_extension_min.PcbDoc]
2020-04-27 mise à jour commande Mouser et schémas
    [Driver_moteur-plateau.SchDoc, Interface_voilier.SchDoc, PCB_Driver_moteur_plateau.PcbDoc, PCB_Interface_voilier.PcbDoc]
2020-09-23 Ajout des fichiers PDF
2020-09-24 Ajout des fichiers Altium de fabrication du boîtier de télécommande.
    [Voilier_telecom_boitier.PcbDoc, Voilier_telecom_cadre.PcbDoc]
2020-12-11 driver usart complet, à tester
2020-12-14 driver xbee a jour, reprise du driver uart
2020-12-16 Debug du drivers xbee: rien ne marche
2020-12-17 Drivers USART et XBEE debuggé en TX
2021-01-15 Debut de modelisation du pont arriere du voilier
    [Pont arriere.iam, Pont arriere.ipt, RDC-250.ipt, Tube alu.ipt, c-5-5530843-4-f-2d.dxf, c-5-5530843-4-f-3d.igs, c-5-5530843-4-f-3d.stp, pcb_connecteur.ipt]
2021-01-15 modelisation rapide de la carte d'acceuil en 3D
    [pcb_accueil.kicad_pcb, pcb_accueil.sch]
2021-01-15 Debut de la conception des equerres
    [COMPOUND.ipt, Equerre_droit.ipt, Equerre_gauche.ipt, PinHeader_2x10_P2.54mm_Vertical.iam, PinSocket_2x20_P2.54mm_Vertical.iam, Pont arriere.iam, SOLID.ipt, SOLID_1.ipt]
2021-01-19 carte pcb_acceuil terminée
    [COMPOUND.ipt, PinHeader_2x10_P2.54mm_Vertical.iam, PinSocket_2x20_P2.54mm_Vertical.iam, SOLID.ipt, SOLID_1.ipt, SOLID_2.ipt, c-5-5530843-4-f-3d.iam, pcb_accueil.iam]
2021-01-19 modif sur la carte etudiant (changement de coté)
    [71600-020_asm.stp, c-1-1734592-0-c-2d.dxf, c-1-1734592-0-c-3d.igs, c-1-1734592-0-c-3d.stp, c-5-5530843-4-f-3d.stp, carte_etudiant.kicad_pcb, carte_etudiant.sch]
2021-01-20 carte terminée
    [carte_etudiant.kicad_pcb, carte_etudiant.sch]
2021-01-20 rajout de trous de precage dans pcb_accueil
    [pcb_accueil.kicad_pcb, pcb_accueil.sch, pcb_accueil.step]
2021-01-21 Modelisation en 3D des carte etudiant et carte d'accueil
    [COMPOUND.ipt, COMPOUND_1.ipt, C_1206_3216Metric.iam, IDC-Header_2x10_P2.54mm_Vertical.iam, LED_1206_3216Metric.iam, NUCLEO-60-F401.iam, PinHeader_1x16_P2.54mm_Vertical.iam, PinSocket_1x16_P2.54mm_Vertical.iam]
2021-01-25 Fixation mecanique sur le plateau fini
    [Ensemble - Glissiere Gauche.iam, Ensemble - Glissiere droite.iam, Equerre_droit.ipt, Equerre_gauche.ipt, Fixation droite.ipt, Fixation gauche.ipt, Plateau.ipt, Pont arriere.iam]
2021-01-26 retournement des connecteurs de bords de carte
    [carte_etudiant.kicad_pcb, pcb_accueil.kicad_pcb]
2021-01-28 Ajout des fichiers stl et stp des fixations
    [Fixation droite.stl, Fixation droite.stp, Fixation gauche.stl, Fixation gauche.stp]
2021-04-30 commit avant changement de branche
2021-05-07 Changement d'orientation sur carte-etudiant et pcb_acceuil
    [carte_etudiant.kicad_pcb, pcb_accueil.kicad_pcb]
2021-05-09 Thierry, ajout revue de projet Mai 2021 dans docs
2021-05-21 glissieres en port a faux
    [Equerre_porte_a_faux_droit.ipt, Equerre_porte_a_faux_gauche.ipt, Pont_arriere.ipt, Tube alu.ipt]
2021-06-11 Modification de la taille de la serigraphie et de son oreintation pour les cartes etudiant
    [carte_etudiant.kicad_pcb]
2021-06-14 Ajout Carte Alim fichier Altium et PDF
    [Voilier_carte_alim.PcbDoc, Voilier_carte_alim.SchDoc]
2021-06-14 Mise à jour carte driver moteur
    [Driver_moteur-plateau.SchDoc, PCB_Driver_moteur_plateau.PcbDoc]
2021-06-15 rajout de plot de masse + changement taille serigraphie sur carte-etudiant
    [carte_etudiant.kicad_pcb, carte_etudiant.sch]
2021-06-29 Version 1.4 de la carte etudiant, ajout de la ligne SPI_CS2
    [carte_etudiant.kicad_pcb, carte_etudiant.sch]
2021-07-02 CORRECTIONS INTERFACE VOILIER
    [Interface_ext_voilier_min.SchDoc, Interface_voilier.SchDoc, PCB_Interface_voilier.PcbDoc, PCB_extension_min.PcbDoc]
2021-07-05 Correction des textes : RX, TX et CS
    [Interface_voilier.SchDoc, PCB_Interface_voilier.PcbDoc]
2021-07-09 Modification empreinte régulateur et ajout modif sérigraphie
    [Interface_voilier.SchDoc, PCB_Interface_voilier.PcbDoc]
2021-07-09 correction sérigraphie, taille
    [PCB_Interface_voilier.PcbDoc]
2021-08-18 Envoi de la rotation toutes les 100 ms + ajout ligne spi_cs2
    [carte_etudiant.kicad_pcb, carte_etudiant.sch]
2021-08-27 Modification pour eviter d'envoyer la vitesse de rotation tant que le Xbee n'est pas configuré
2021-09-08 export PDF des fichiers kicad de la carte etudiant
2024-11-21 Ajout des informations de configuration du XBEE dans le fichier readm.md principal
