INSA-GEI/Voilier/(notices)

Notices in the files:
code/Console-Pilotage/Core/Inc/main.h:
© Copyright (c) 2020 STMicroelectronics.
All rights reserved.
This software component is licensed by ST under Ultimate Liberty license
code/Console-Pilotage/Core/Src/main.c:
© Copyright (c) 2019 STMicroelectronics.
